daiooo/sistemas-de-aterramento/README.md

Sistemas de Aterramento
=======

Projeto: Sistemas de Aterramento

### Equipe:
* Ricardo Thé
* Tobias Fernandes
* Rodrigo Paulino
* Felipe Bandeira 
* Franscico Alexandre
* António Thé
* Henrique
* Rooney
* Kristian 
* Alberto de Castro

felipeband18 at gmail dot com
