daiooo/sistemas-de-aterramento/esquematico/placa_potencia_versao_2/gerb/LEIAME

LEGENDA:
    Top and bottom copper (.GTL, .GBL)
    Top and bottom solder mask (.GTS, .GBS)
    Top and bottom silkscreen (.GTO, .GBO)
    Drill file, 2.4 leading (.TXT)
	MILL and Dimension (.GML)
