daiooo/sistemas-de-aterramento/esquematico/placa_tobias/gerb/LEIAME

LEGENDA:
    Top and bottom copper (.GTL, .GBL)
    Drill file, 2.4 leading (.TXT)
    MILL and Dimension (.GML)
