daiooo/sistemas-de-aterramento/esquematico/placa_controle/gerber_controle/controle - CADCAM Mechanical 1.TXT

G04 PROTEUS RS274X GERBER FILE*
%FSLAX24Y24*%
%MOIN*%
%ADD16C,0.0080*%
G54D16*
X-32952Y-37468D02*
X+30000Y-37468D01*
X+30000Y+10500D01*
X-32952Y+10500D01*
X-32952Y-37468D01*
M00*
