daiooo/sistemas-de-aterramento/esquematico/placa_potencia/gerbes_potencia/potencia - CADCAM Mechanical 1.TXT

G04 PROTEUS RS274X GERBER FILE*
%FSLAX24Y24*%
%MOIN*%
%ADD13C,0.0080*%
G54D13*
X-33000Y-22500D02*
X+30000Y-22500D01*
X+30000Y+26000D01*
X-33000Y+26000D01*
X-33000Y-22500D01*
M00*
