daiooo/sistemas-de-aterramento/fotos/conexoes/frontal.pdf

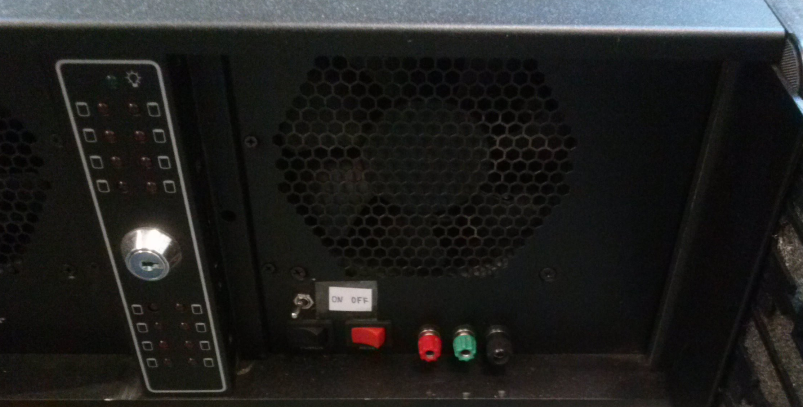
[picture p12: page 1]
