daiooo/sistemas-de-aterramento/fotos/execucao/terminal.pdf

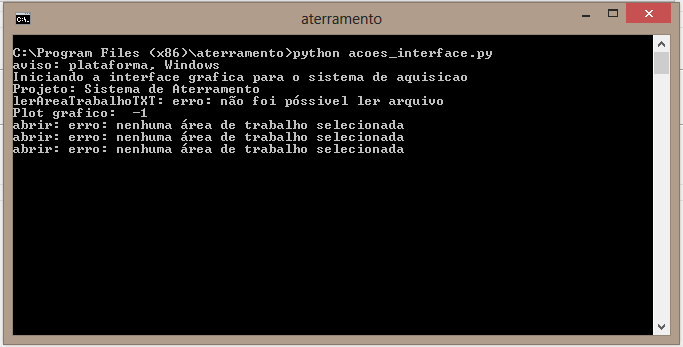
[picture p13: page 1]
