daiooo/sistemas-de-aterramento/fotos/instalacao/parte1_executando.pdf

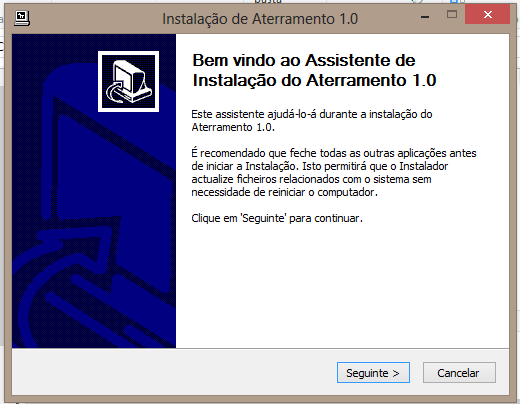
[picture p14: page 1]
