daiooo/sistemas-de-aterramento/fotos/instalacao/parte3_descompactando.pdf

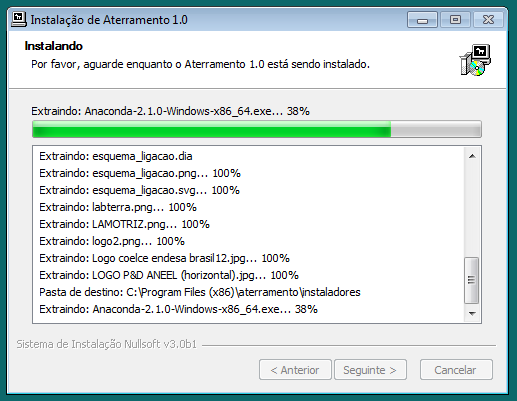
[picture p15: page 1]
