daiooo/sistemas-de-aterramento/fotos/instalacao/parte5_instalando_pyvisa.pdf

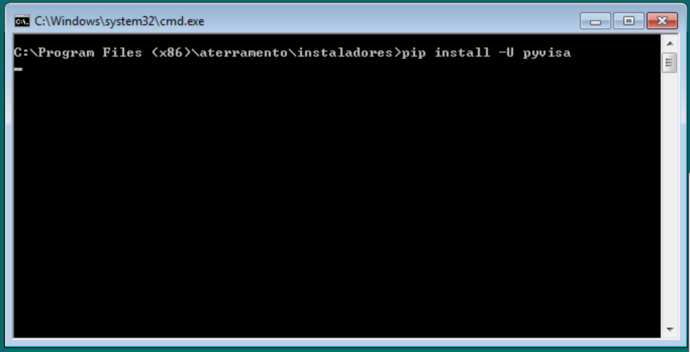
[picture p16: page 1]
