daiooo/sistemas-de-aterramento/fotos/instalacao/parte6_pyqt.pdf

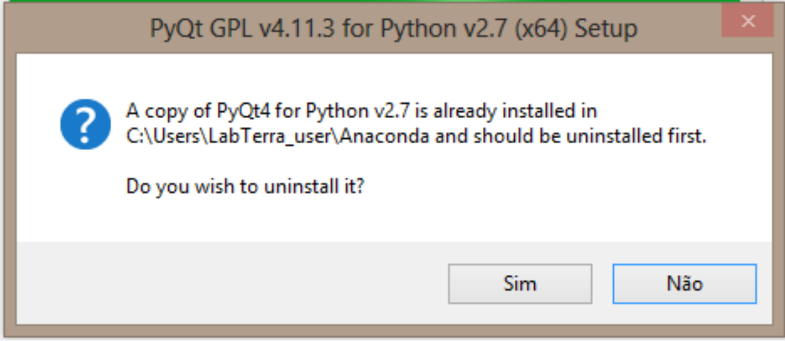
[picture p17: page 1]
