daiooo/sistemas-de-aterramento/fotos/CAM00064.jpg

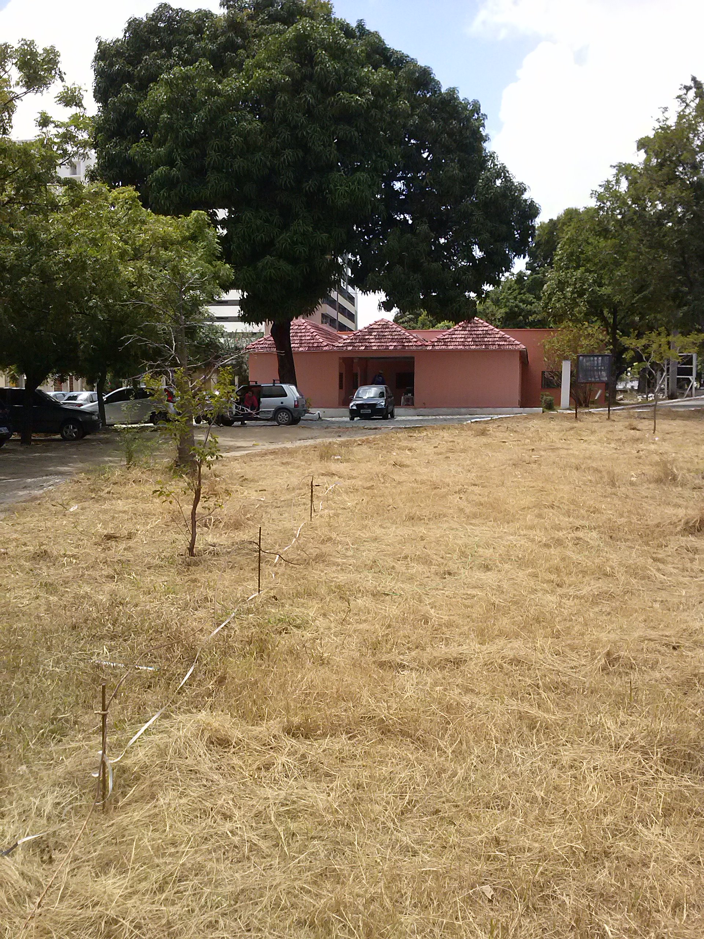
fotos/CAM00064.jpg
