daiooo/sistemas-de-aterramento/fotos/CAM00080.jpg

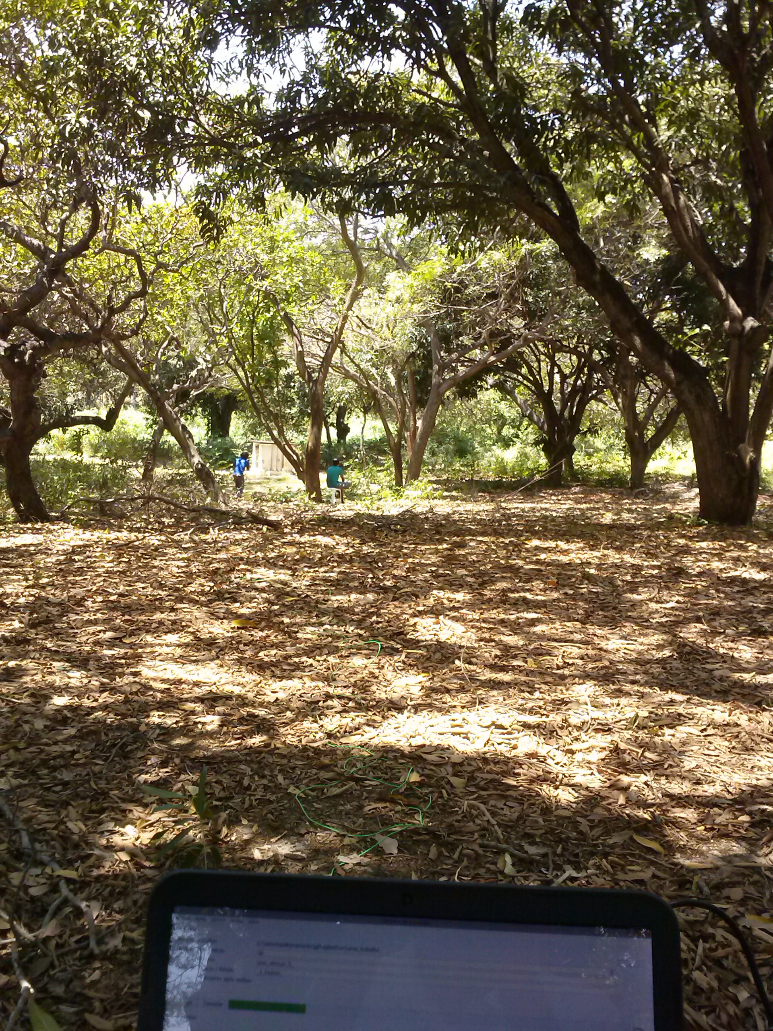
fotos/CAM00080.jpg
