daiooo/sistemas-de-aterramento/fotos/CAM00374.jpg

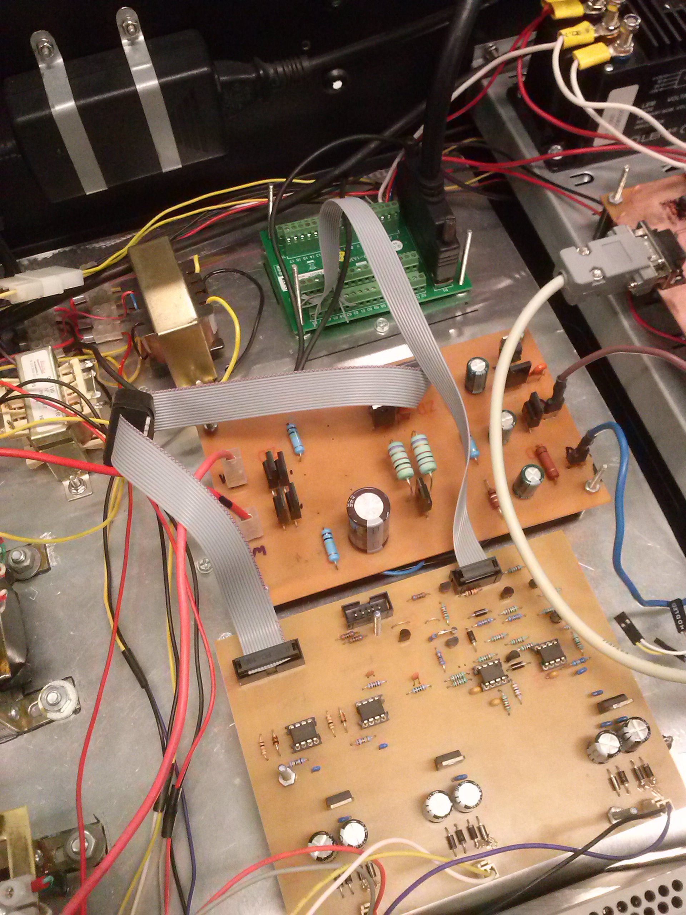
fotos/CAM00374.jpg
