daiooo/sistemas-de-aterramento/fotos/CAM00375.jpg

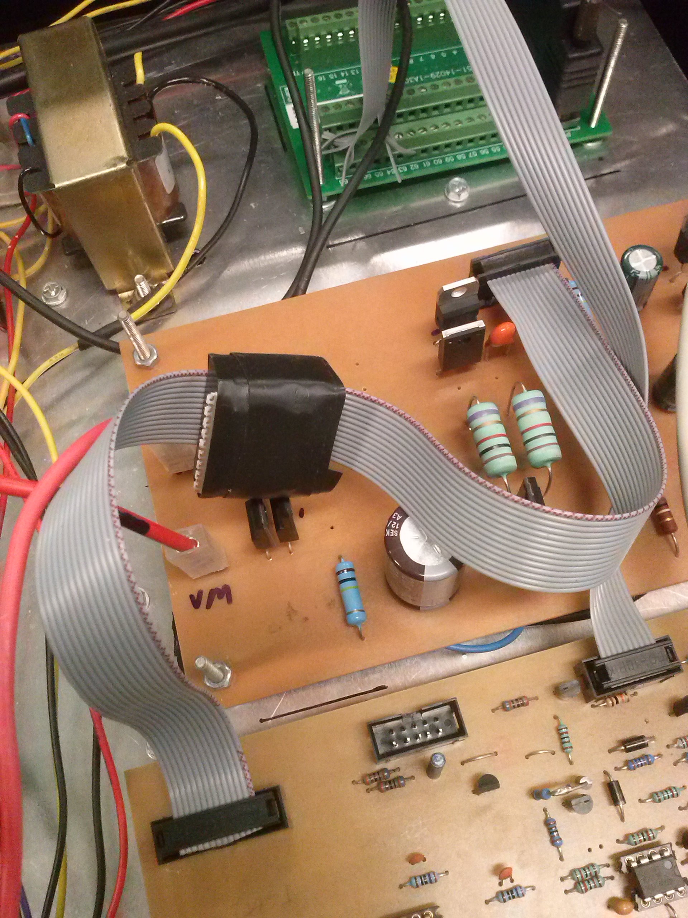
fotos/CAM00375.jpg
