daiooo/sistemas-de-aterramento/fotos/CAM00376.jpg

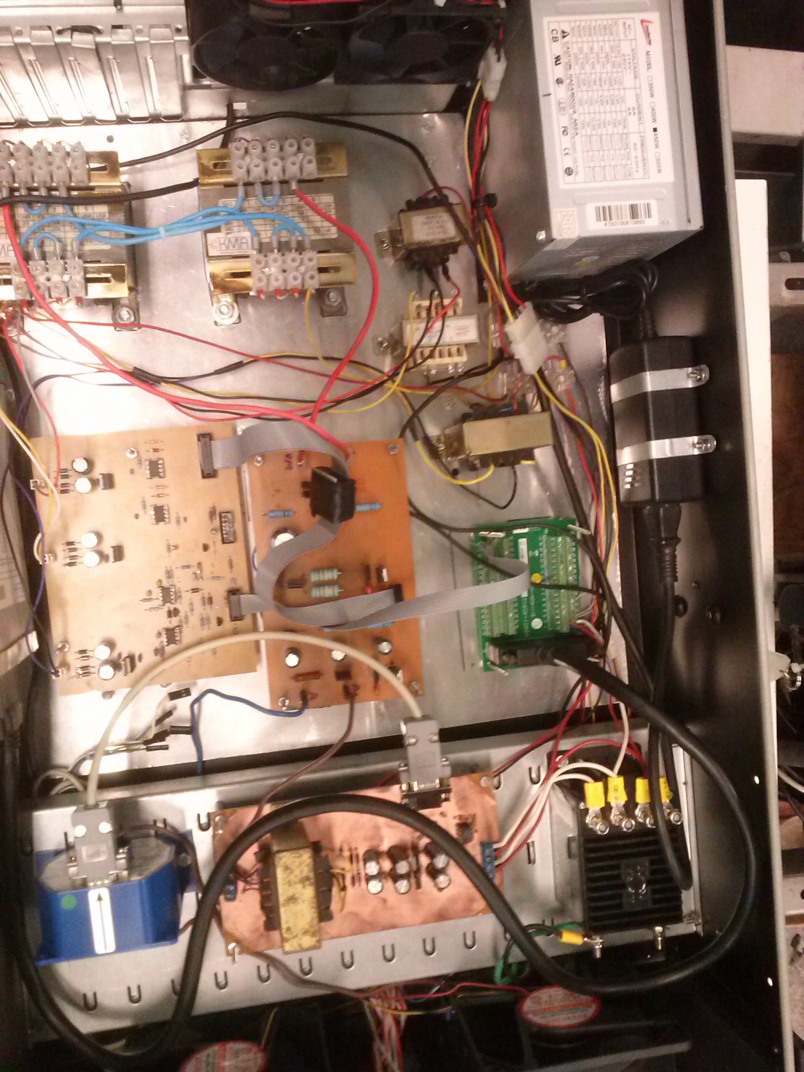
fotos/CAM00376.jpg
