daiooo/sistemas-de-aterramento/fotos/CAM00377.jpg

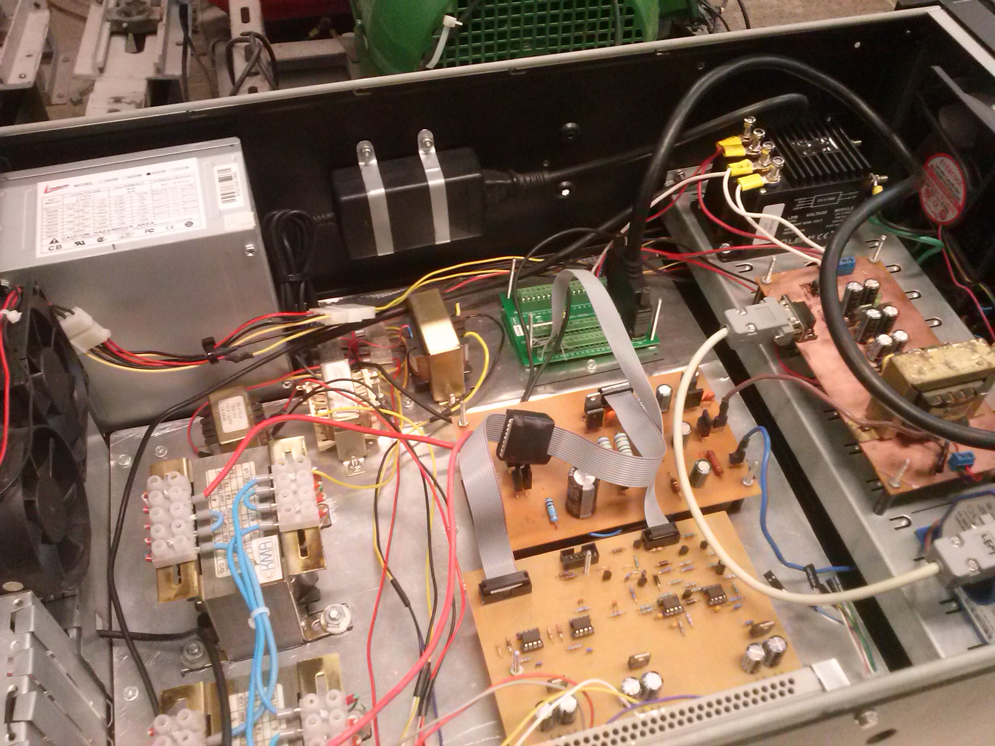
fotos/CAM00377.jpg
