daiooo/sistemas-de-aterramento/fotos/CAM00378.jpg

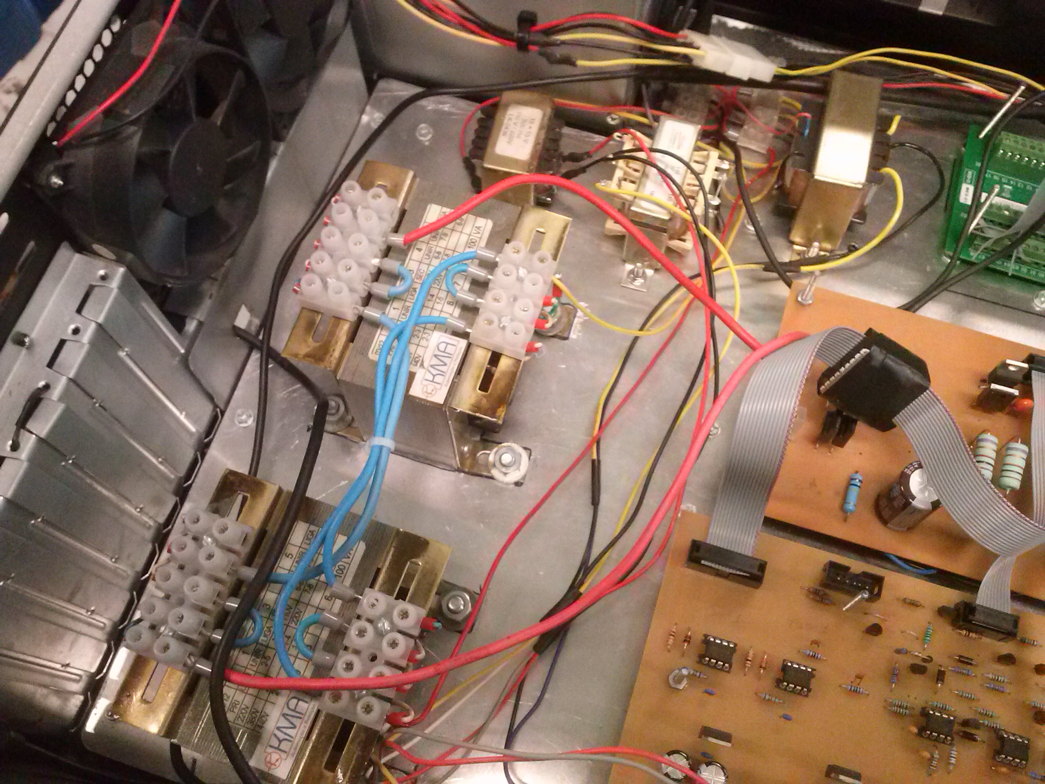
fotos/CAM00378.jpg
