daiooo/sistemas-de-aterramento/fotos/CAM00713.jpg

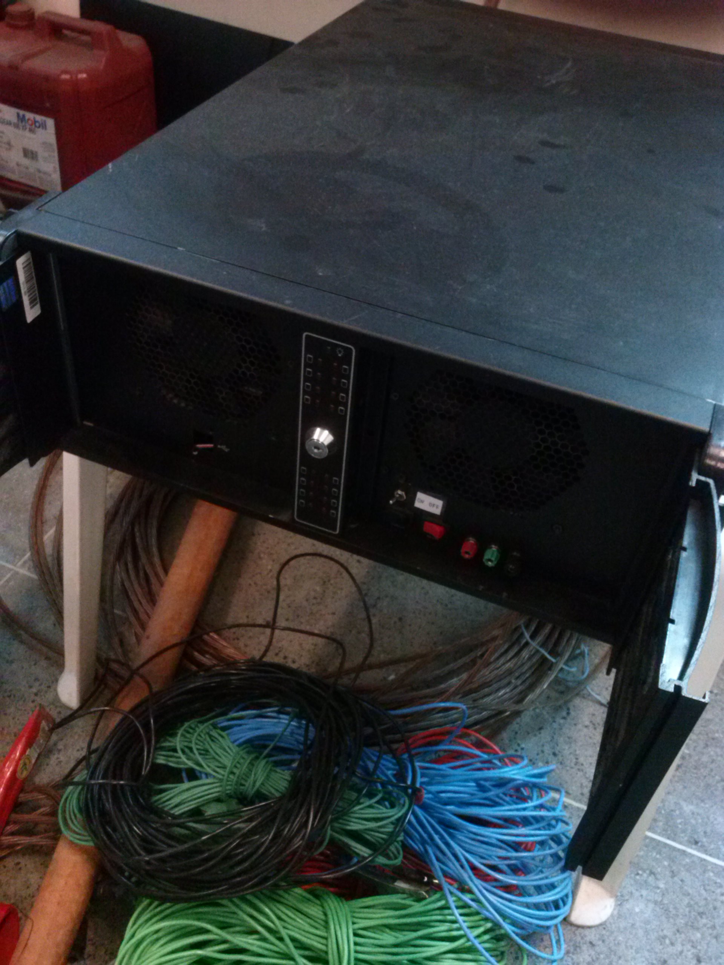
fotos/CAM00713.jpg
