daiooo/sistemas-de-aterramento/fotos/CAM00714.jpg

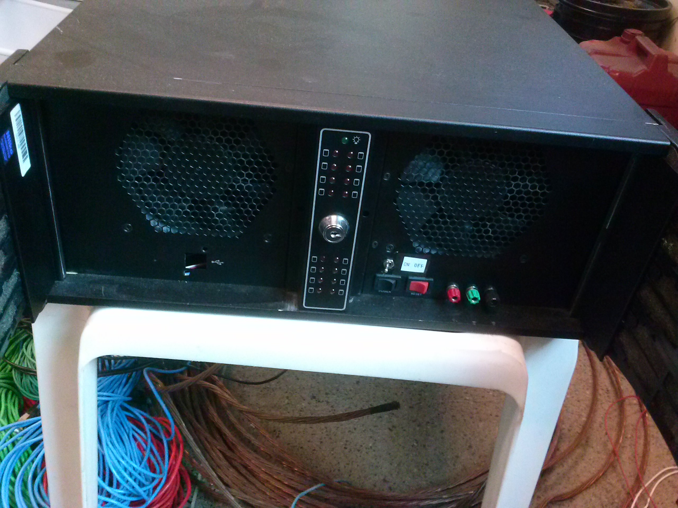
fotos/CAM00714.jpg
