daiooo/sistemas-de-aterramento/fotos/CAM00715.jpg

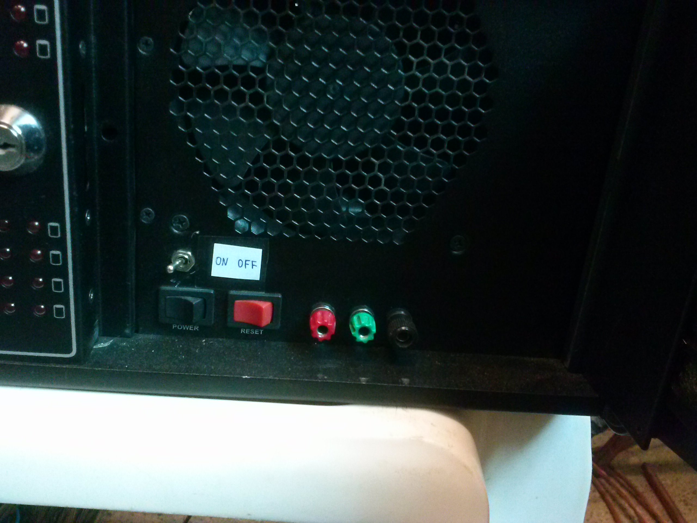
fotos/CAM00715.jpg
