daiooo/sistemas-de-aterramento/fotos/CAM00716.jpg

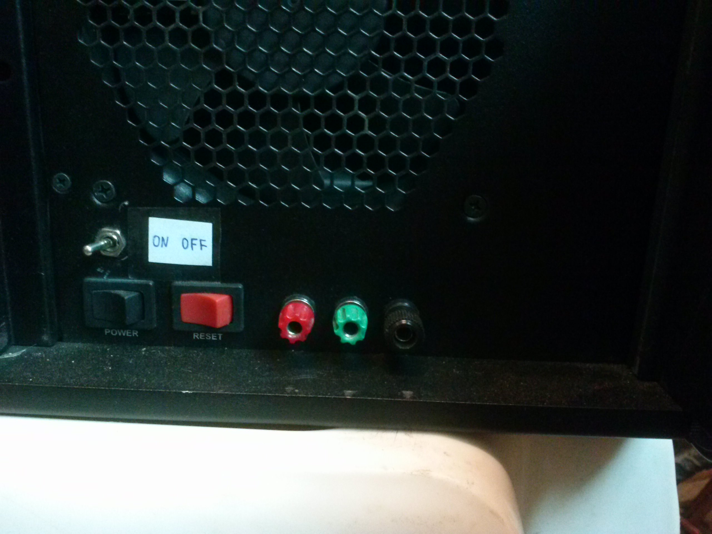
fotos/CAM00716.jpg
