daiooo/sistemas-de-aterramento/fotos/CAM00717.jpg

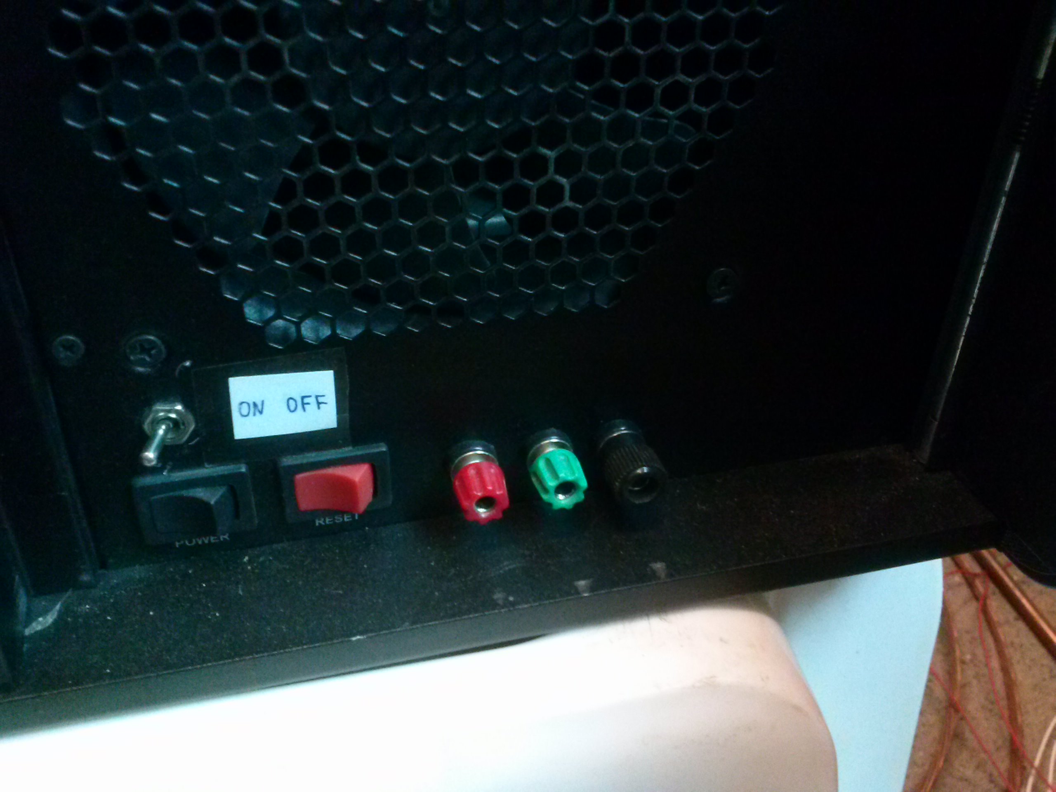
fotos/CAM00717.jpg
