daiooo/sistemas-de-aterramento/fotos/CAM00718.jpg

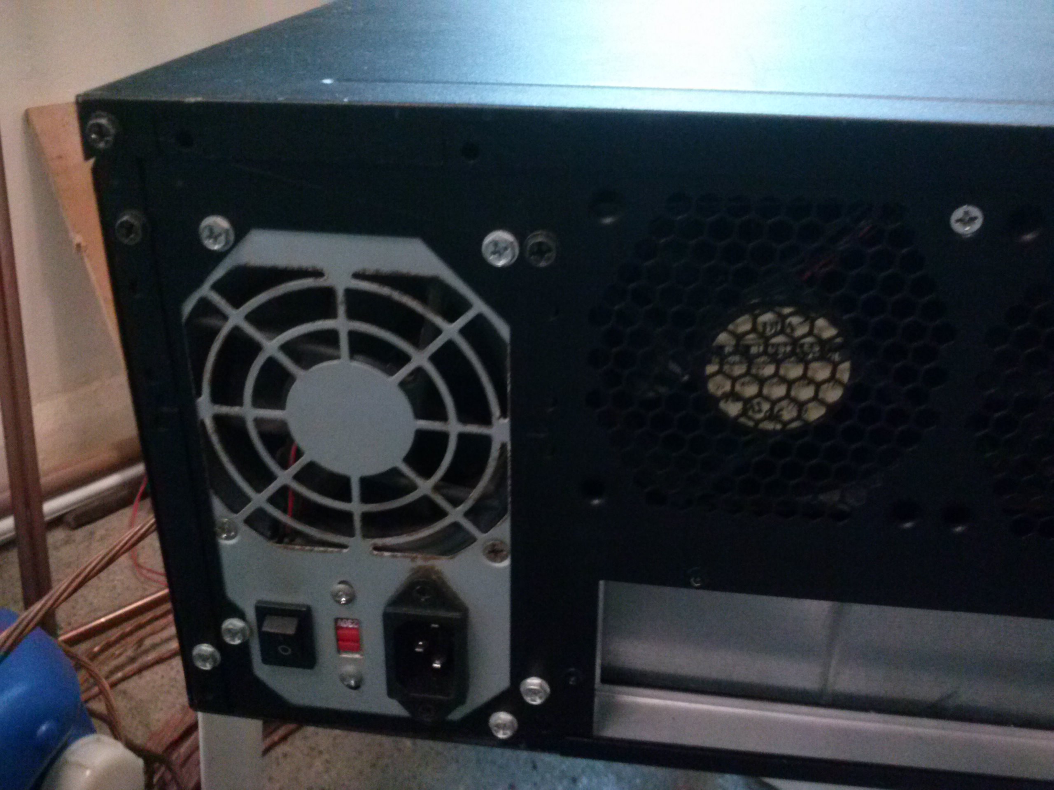
fotos/CAM00718.jpg
