daiooo/sistemas-de-aterramento/fotos/CAM00719.jpg

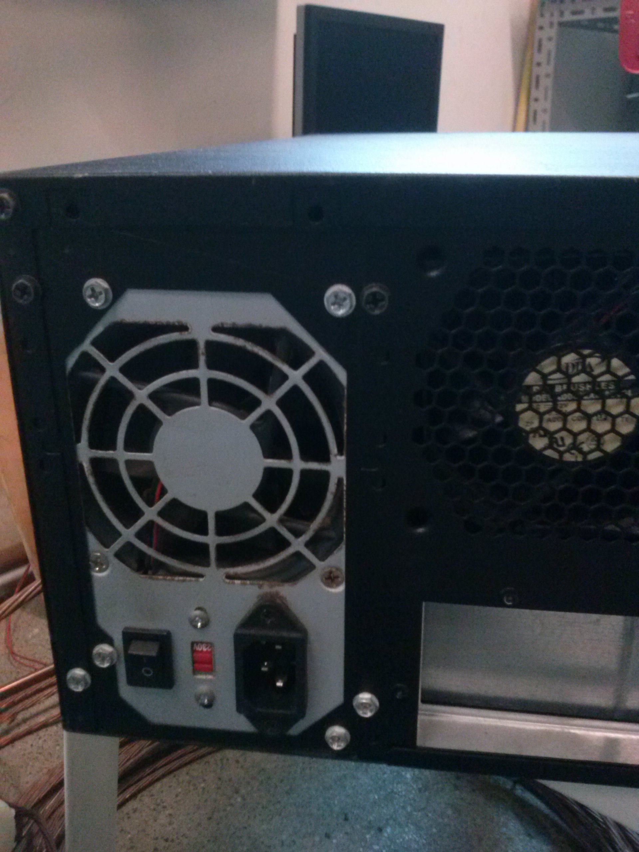
fotos/CAM00719.jpg
