daiooo/sistemas-de-aterramento/fotos/CAM00720.jpg

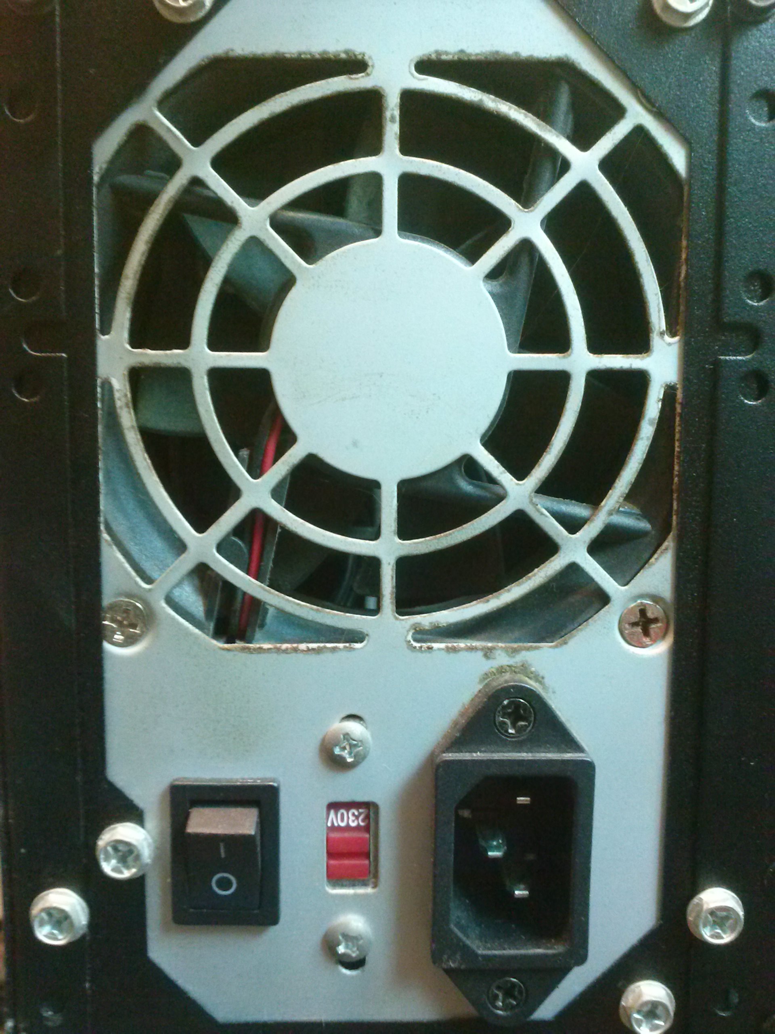
fotos/CAM00720.jpg
