daiooo/sistemas-de-aterramento/fotos/CAM00721.jpg

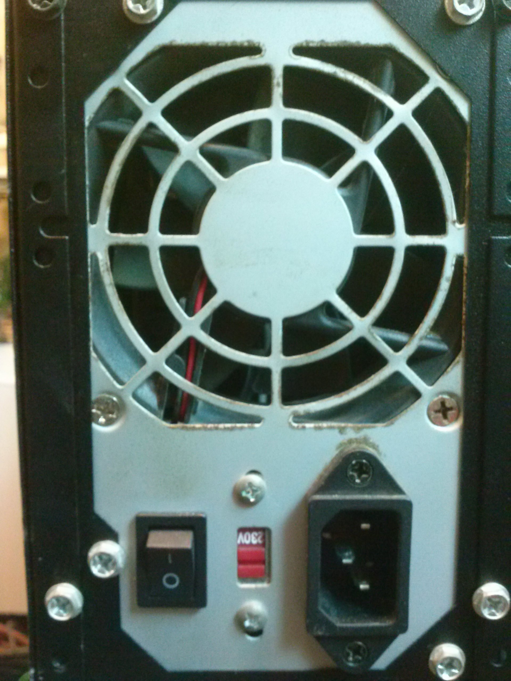
fotos/CAM00721.jpg
