daiooo/sistemas-de-aterramento/fotos/CAM00741.jpg

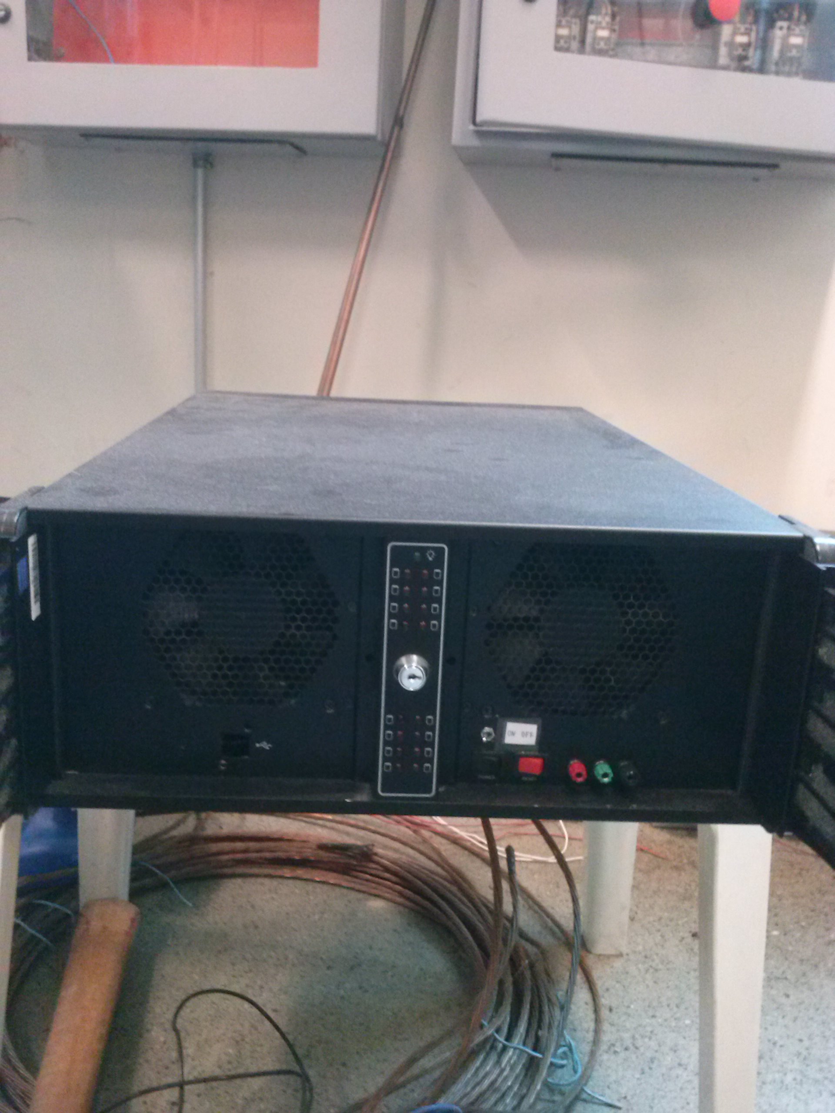
fotos/CAM00741.jpg
