daiooo/sistemas-de-aterramento/fotos/CAM00742.jpg

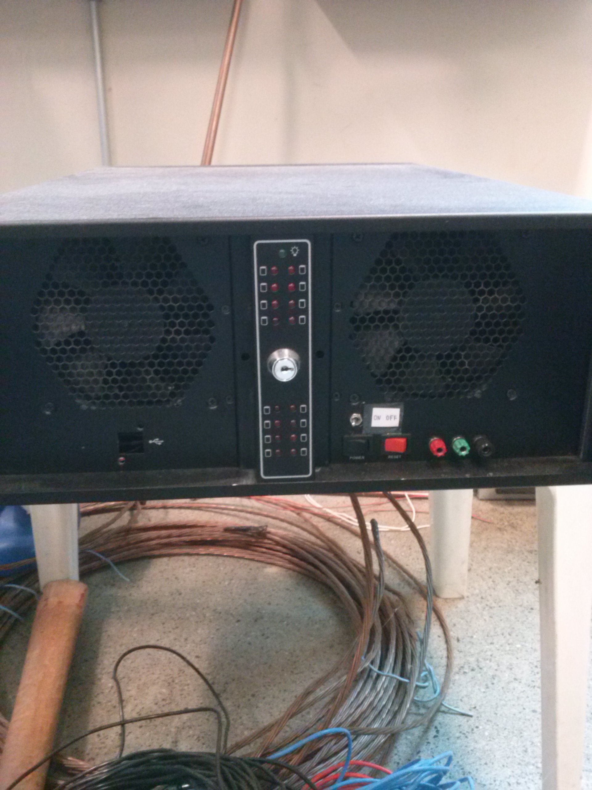
fotos/CAM00742.jpg
