daiooo/sistemas-de-aterramento/fotos/CAM00743.jpg

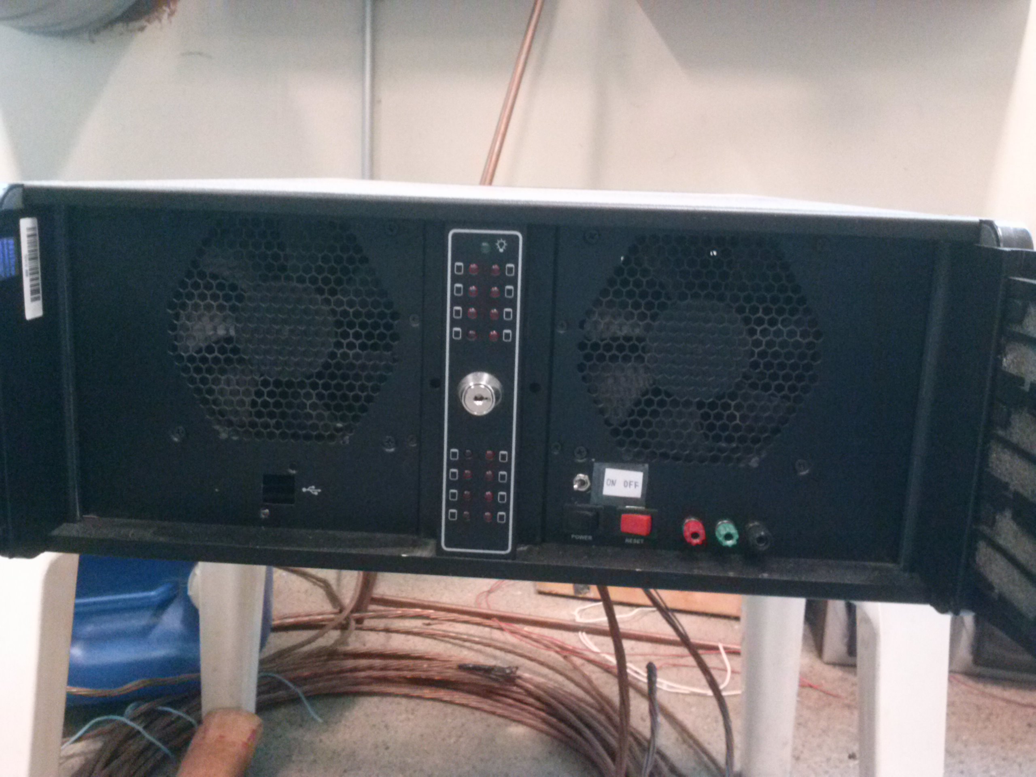
fotos/CAM00743.jpg
