daiooo/sistemas-de-aterramento/fotos/CAM00744.jpg

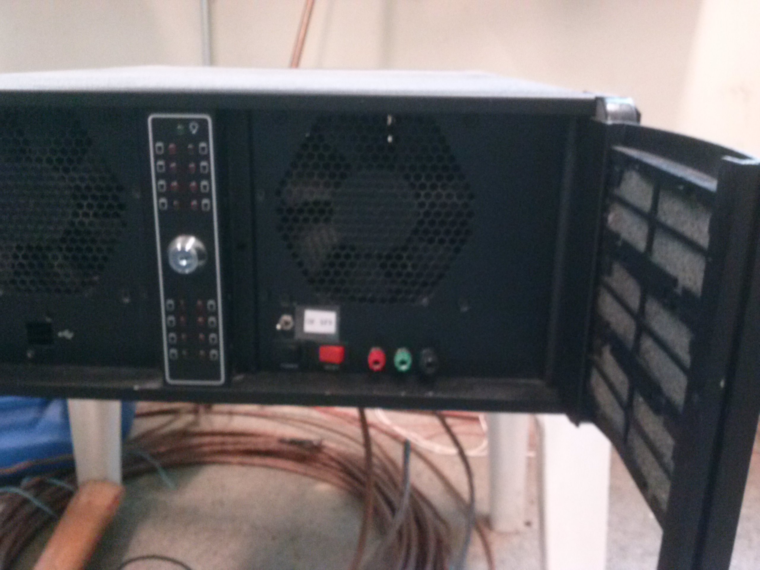
fotos/CAM00744.jpg
