daiooo/sistemas-de-aterramento/fotos/CAM00745.jpg

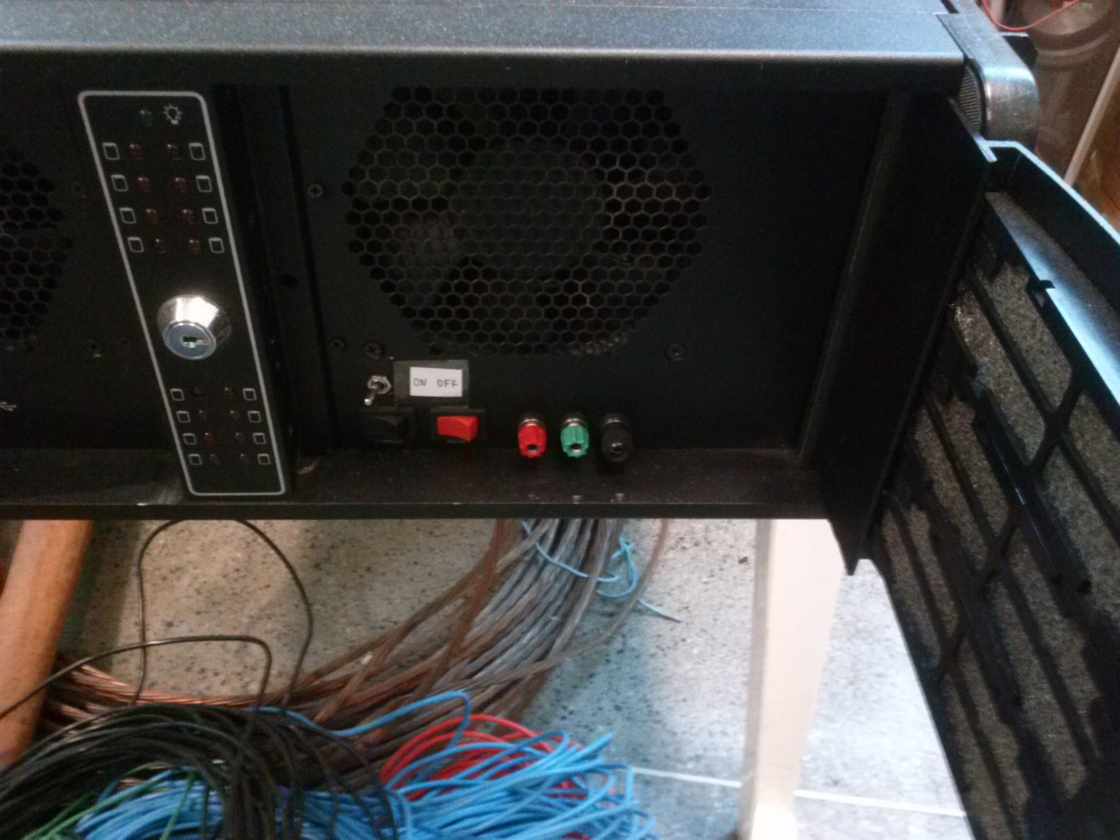
fotos/CAM00745.jpg
