daiooo/sistemas-de-aterramento/fotos/execucao/selecionando_area_trabalho.png

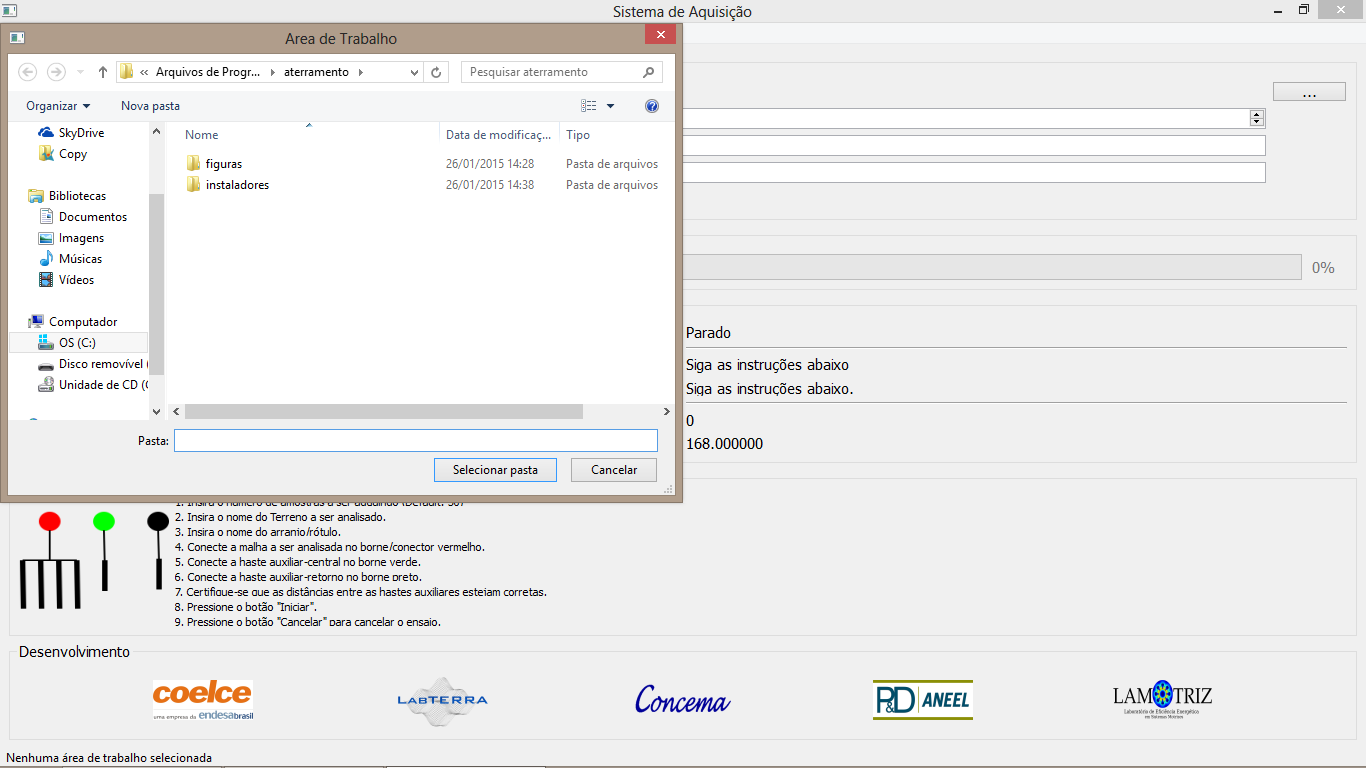
fotos/execucao/selecionando_area_trabalho.png
