daiooo/sistemas-de-aterramento/fotos/execucao/terminal.png

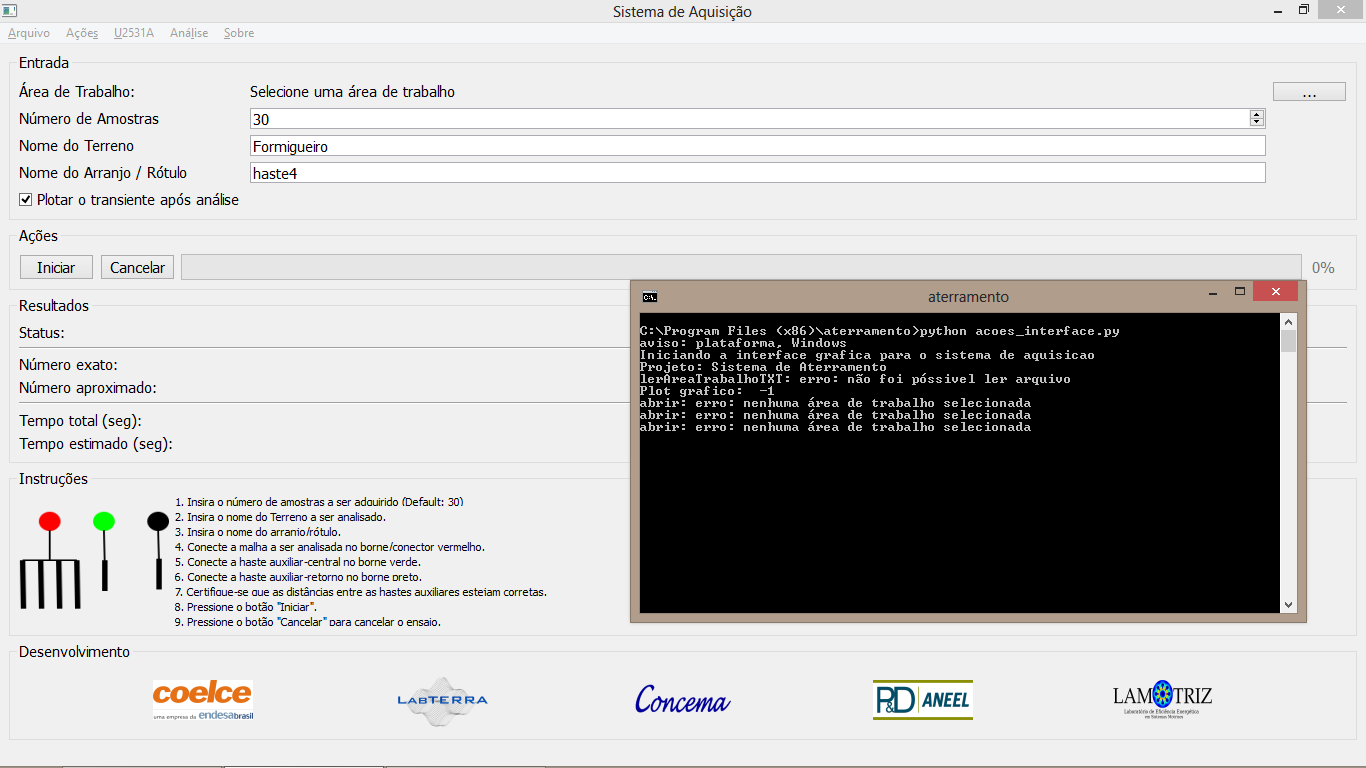
fotos/execucao/terminal.png
