daiooo/sistemas-de-aterramento/fotos/u2531a.png

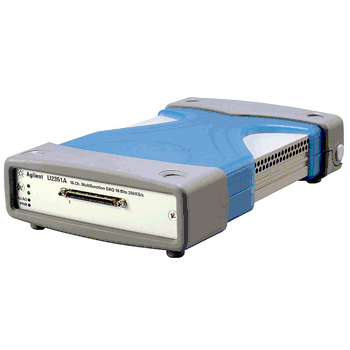
fotos/u2531a.png
