daiooo/sistemas-de-aterramento/src/figuras/esquema_ligacao.png

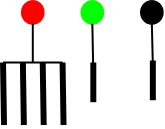
src/figuras/esquema_ligacao.png
