daiooo/sistemas-de-aterramento/src/figuras/labterra.png

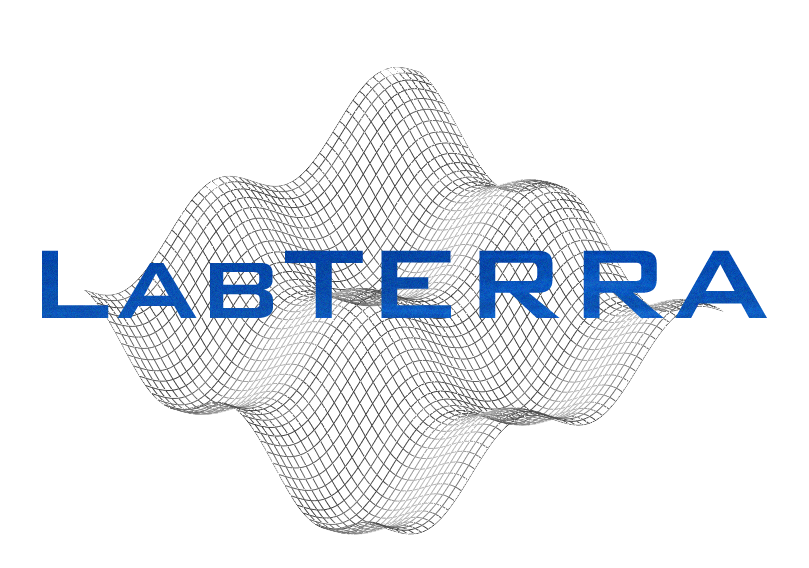
src/figuras/labterra.png
