daiooo/sistemas-de-aterramento/src/figuras/LAMOTRIZ.png

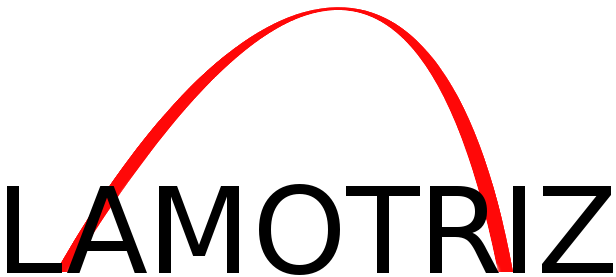
src/figuras/LAMOTRIZ.png
