daiooo/sistemas-de-aterramento/fotos/instalacao/parte2_selecionando_componentes.pdf

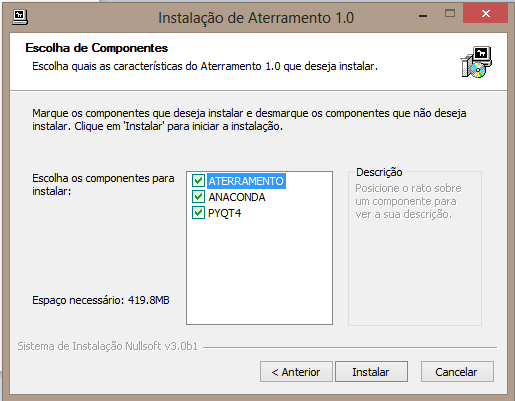
[picture p45: page 1]
