daiooo/sistemas-de-aterramento/fotos/instalacao/parte4_instalando_componentes_externos.pdf

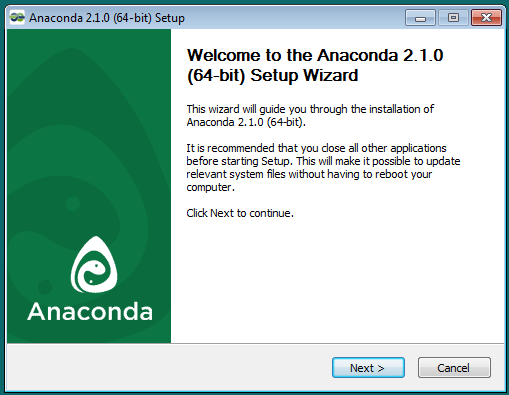
[picture p46: page 1]
