daiooo/sistemas-de-aterramento/(list of files, cad)

Other CAD files:
p16/dist/default/production/p16.production.obj
p16/l.obj
