daiooo/sistemas-de-aterramento/manual/esquema_de_ligacao.pdf

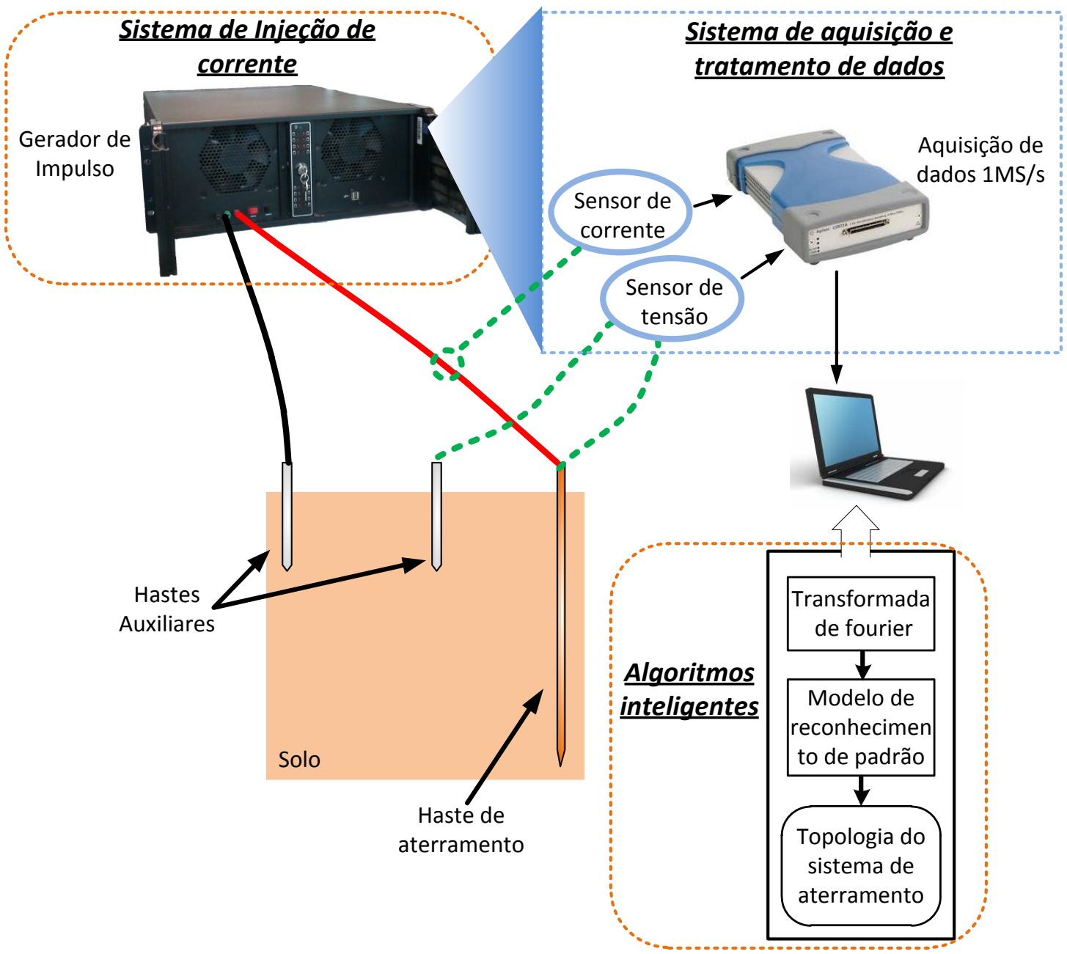
[picture p47: figure]
Solo; Hastes Auxiliares; Haste de aterramento; Gerador de Impulso; Aquisição de dados 1MS/s; Transformada de fourier; Modelo de reconhecimen to de padrão; Topologia do sistema de aterramento; Sensor de tensão; Sensor de corrente; Sistema de Injeção de corrente; Sistema de aquisição e tratamento de dados; Algoritmos inteligentes
