daiooo/sistemas-de-aterramento/esquematico/placa_controle/gerber_controle/controle - CADCAM Bottom Solder Resist.TXT

G04 PROTEUS RS274X GERBER FILE*
%FSLAX24Y24*%
%MOIN*%
%ADD20C,0.1381*%
%ADD21C,0.0987*%
%ADD22R,0.0987X0.0987*%
%ADD23C,0.0790*%
%ADD16C,0.0080*%
G54D20*
X-2000Y-30000D03*
X+1000Y-30000D03*
X-6791Y-28729D03*
X-4500Y-29000D03*
G54D21*
X-26515Y+8500D03*
X-25515Y+8500D03*
G54D20*
X-28000Y+5500D03*
X-28000Y+1500D03*
X-22500Y+1500D03*
X-22500Y+5500D03*
X-28000Y-1500D03*
X-26000Y-1500D03*
X-23500Y-1500D03*
X-21500Y-1500D03*
G54D21*
X-26500Y-4500D03*
X-27500Y-4500D03*
X-25000Y-4500D03*
X-24000Y-4500D03*
X+500Y+8500D03*
X+1500Y+8500D03*
G54D20*
X+500Y+5500D03*
X+500Y+1500D03*
X-1000Y+5500D03*
X-1000Y+1500D03*
X+2500Y+1500D03*
X+2500Y+5500D03*
X+4000Y+1500D03*
X+4000Y+5500D03*
X-1000Y-1500D03*
X+1000Y-1500D03*
X+3500Y-1500D03*
X+5500Y-1500D03*
G54D21*
X+500Y-4500D03*
X-500Y-4500D03*
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
