daiooo/sistemas-de-aterramento/esquematico/placa_potencia/gerbes_potencia/potencia - CADCAM Bottom Solder Resist.TXT

G04 PROTEUS RS274X GERBER FILE*
%FSLAX24Y24*%
%MOIN*%
%ADD15R,0.1381X0.0987*%
%ADD16C,0.1381*%
%ADD17C,0.0987*%
%ADD13C,0.0080*%
G54D15*
X-30000Y+3500D03*
X-30000Y+2500D03*
X-30000Y+1500D03*
X-30000Y+500D03*
G54D16*
X-25000Y+7500D03*
X-25000Y+9500D03*
X-21500Y+7500D03*
X-21500Y+9500D03*
X-25000Y-5500D03*
X-25000Y-3500D03*
X-21500Y-5500D03*
X-21500Y-3500D03*
X-12000Y+22000D03*
X-12000Y+18850D03*
X-12000Y+13000D03*
X-12000Y+9850D03*
X-12000Y+4000D03*
X-12000Y+850D03*
X-12000Y-5000D03*
X-12000Y-8149D03*
X-12000Y-13500D03*
X-12000Y-16649D03*
X-16500Y+16000D03*
X-7500Y+16000D03*
X-16500Y+7000D03*
X-7500Y+7000D03*
X-16500Y-2000D03*
X-7500Y-2000D03*
X-16500Y-11000D03*
X-7500Y-11000D03*
X-16500Y-19500D03*
X-7500Y-19500D03*
X+3000Y+5500D03*
X+3000Y+14500D03*
X+7000Y+5500D03*
X+7000Y+14500D03*
X+5000Y+3000D03*
X+5000Y+1000D03*
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
