daiooo/sistemas-de-aterramento/esquematico/placa_controle/controle_esquematico.pdf

| A | B | C | D | E | F | G | H | J | K
0 | U1 | | | | | | | | | | 0

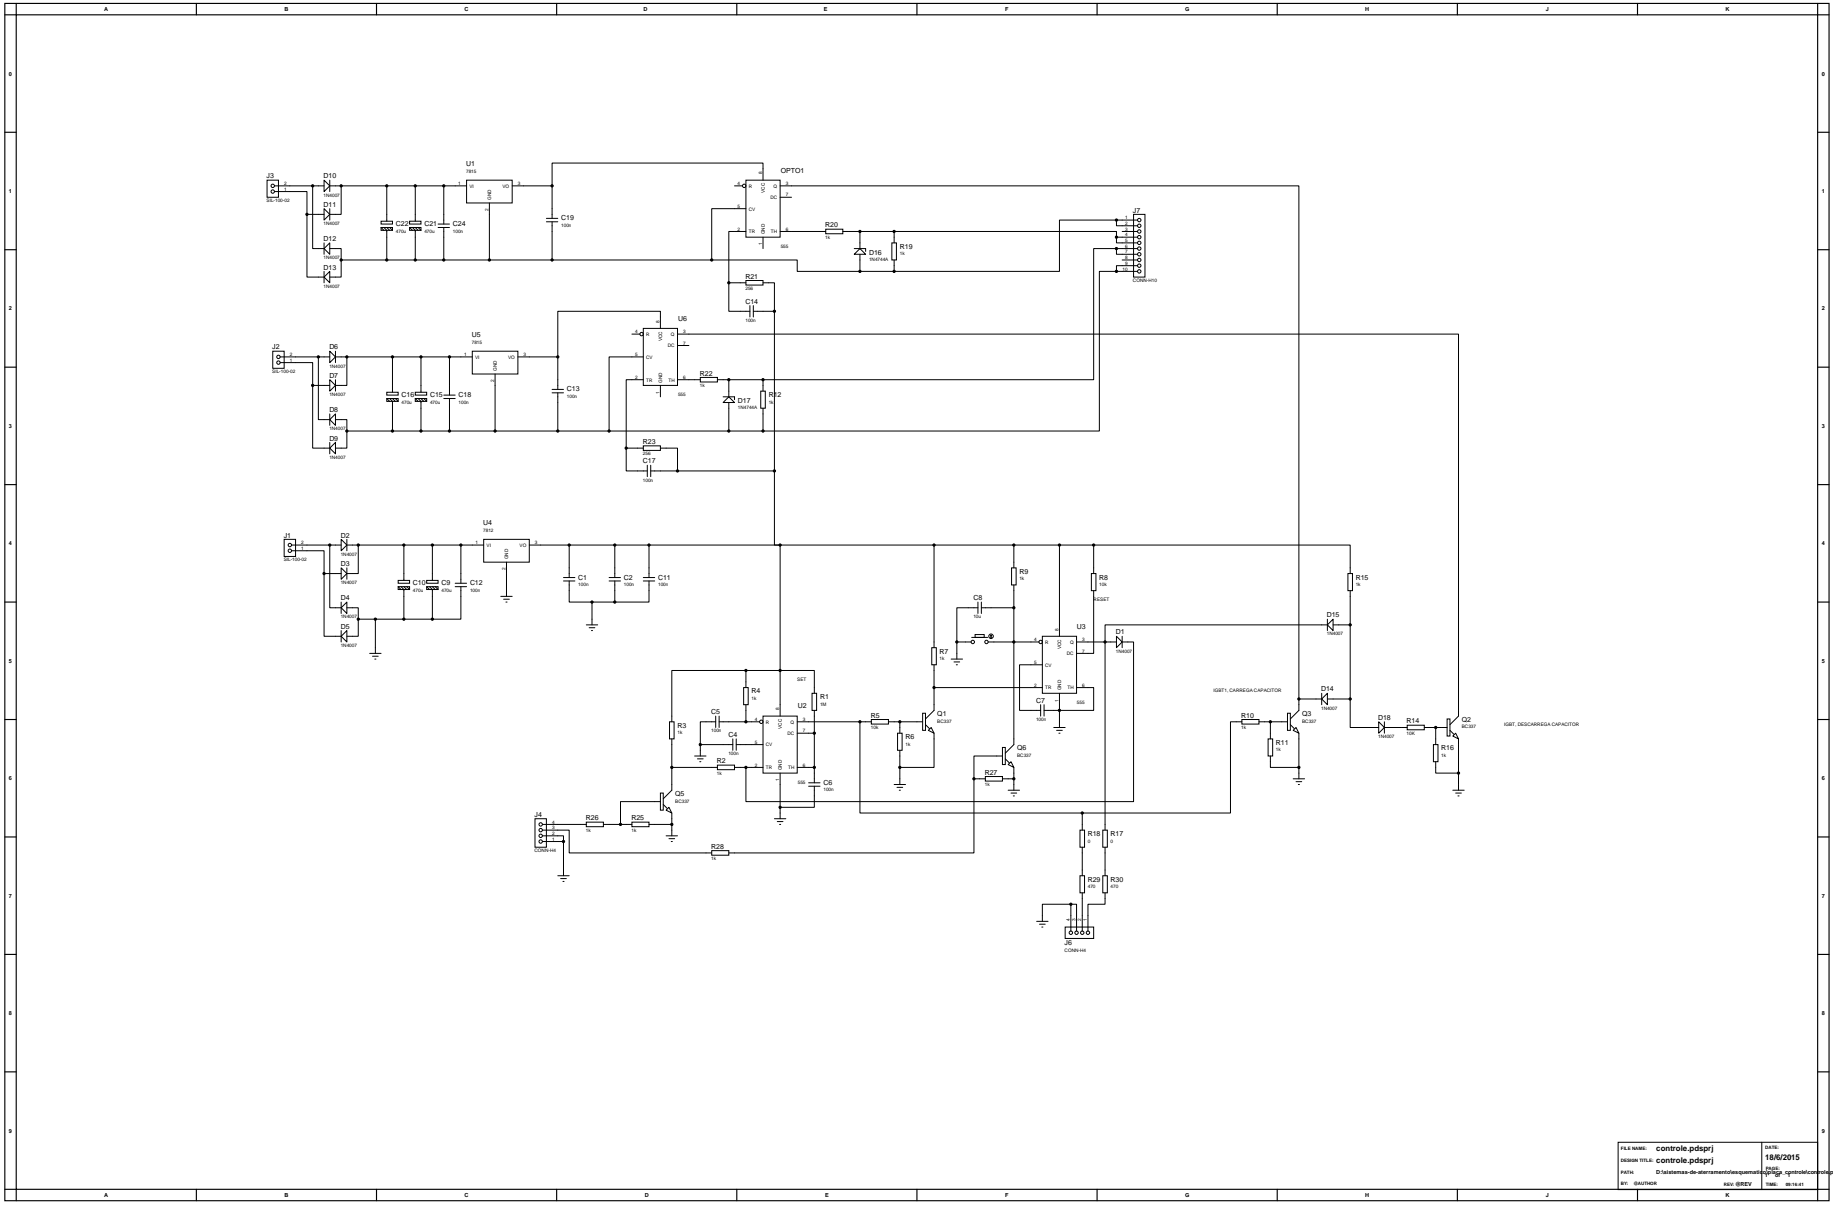
[picture p64: page 1]

GND 1 VCC 8 TR 2 TH 6 CV 5 OPTO1 555

GND 1 VCC 8 TR 2 TH 6 CV 5 U6 555

GND 1 VCC 8 TR 2 TH 6 CV 5 U3 555 SET

GND 1 VCC 8 TR 2 TH 6 CV 5 U2 555

controle.pdsprj FILE NAME: DESIGN TITLE: controle.pdsprj PATH: D:\sistemas-de-aterramento\esquematico\placa_controle\controle.p 1 of 1 BY: @AUTHOR REV:@REV | DATE: 18/6/2015 PAGE: TIME: 09:16:41
