daiooo/sistemas-de-aterramento/esquematico/placa_tobias/placa_TC.pdf

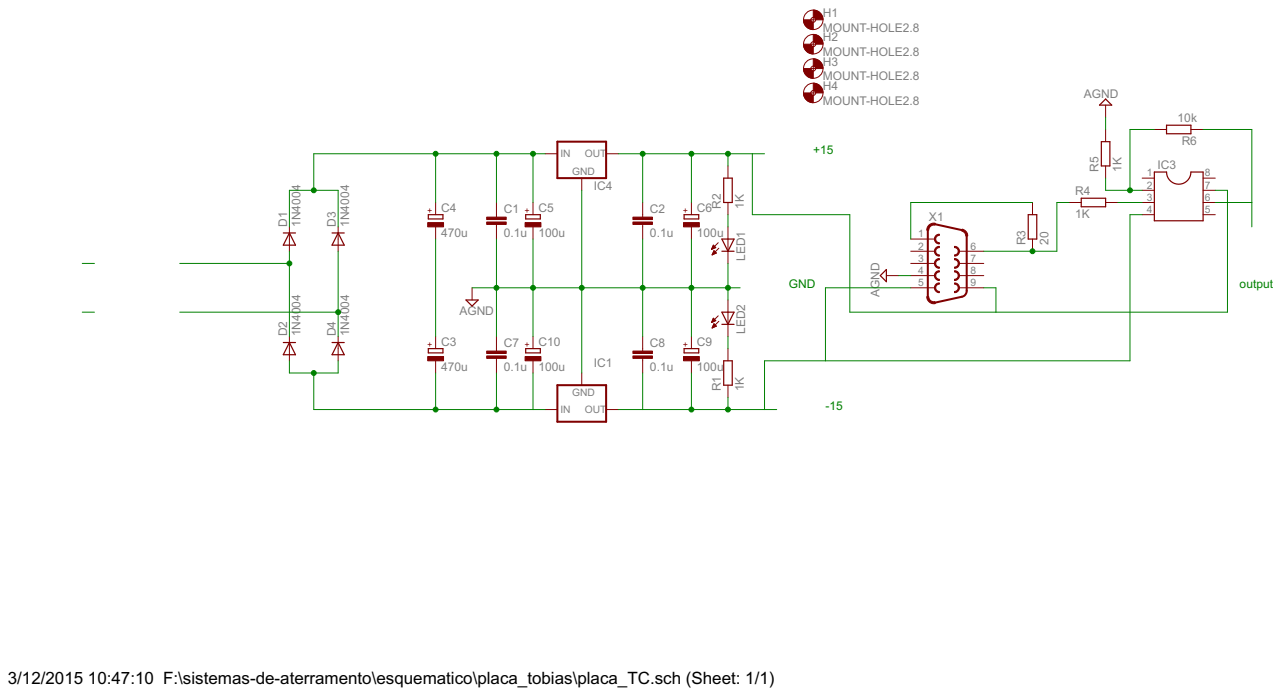
[picture p65: page 1]

3/12/2015 10:47:10 F:\sistemas-de-aterramento\esquematico\placa_tobias\placa_TC.sch (Sheet: 1/1)
