daiooo/sistemas-de-aterramento/esquematico/placa_tobias/placa_TC_pcb.pdf

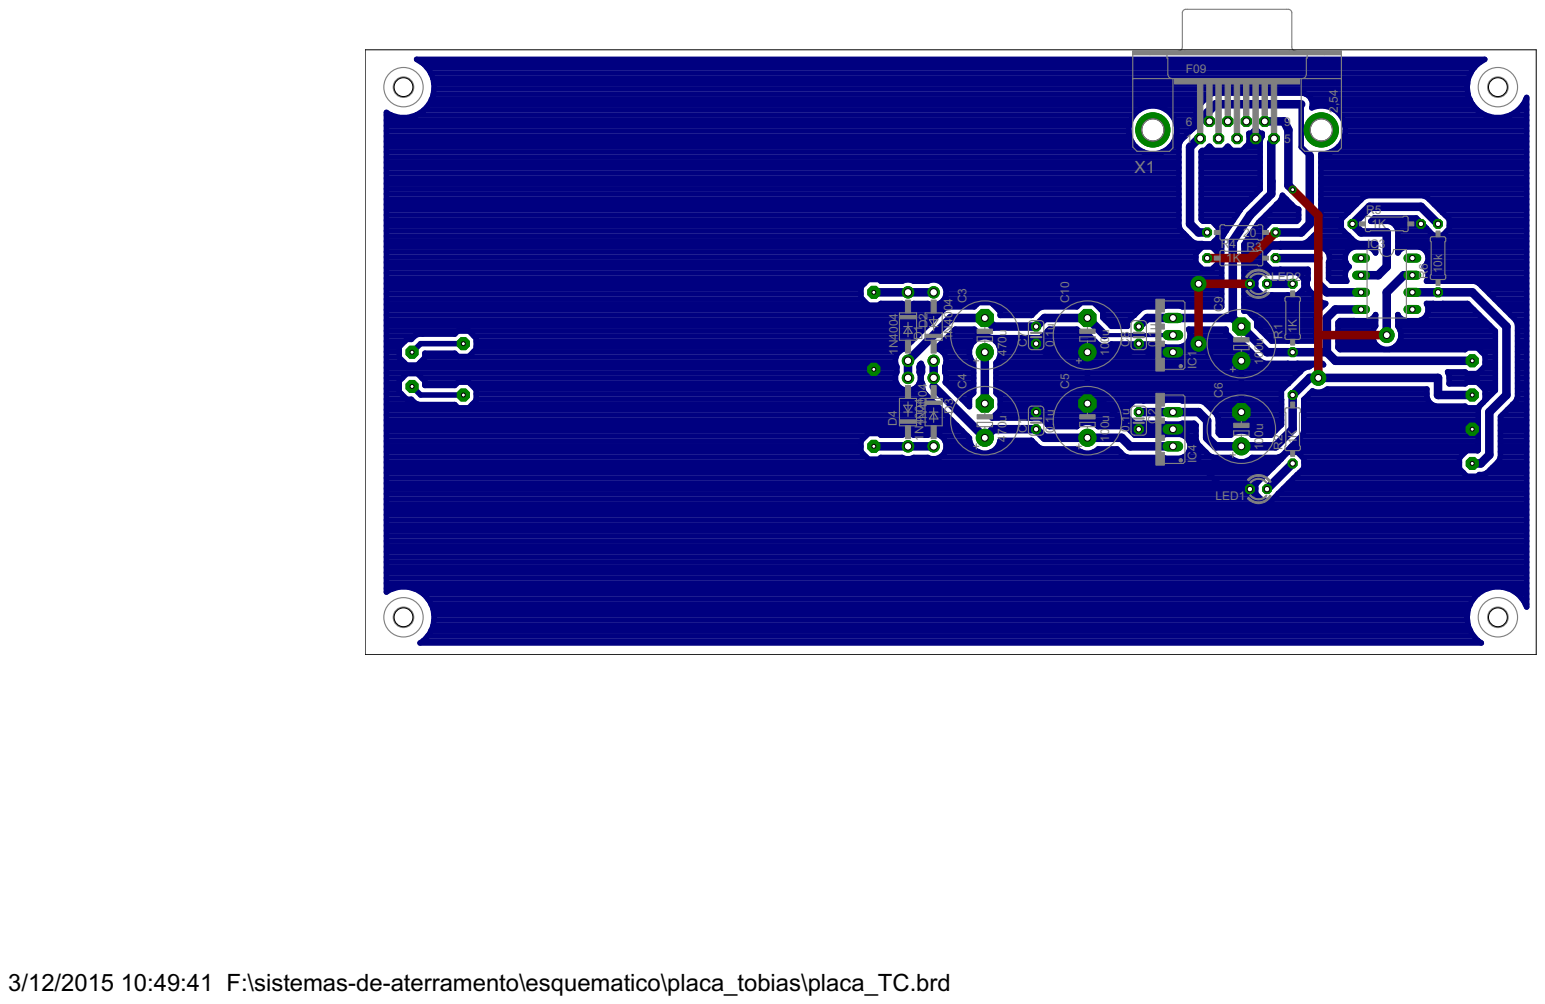
[picture p66: page 1]

3/12/2015 10:49:41 F:\sistemas-de-aterramento\esquematico\placa_tobias\placa_TC.brd
