daiooo/sistemas-de-aterramento/esquematico/placa_controle/controle_pcb.pdf

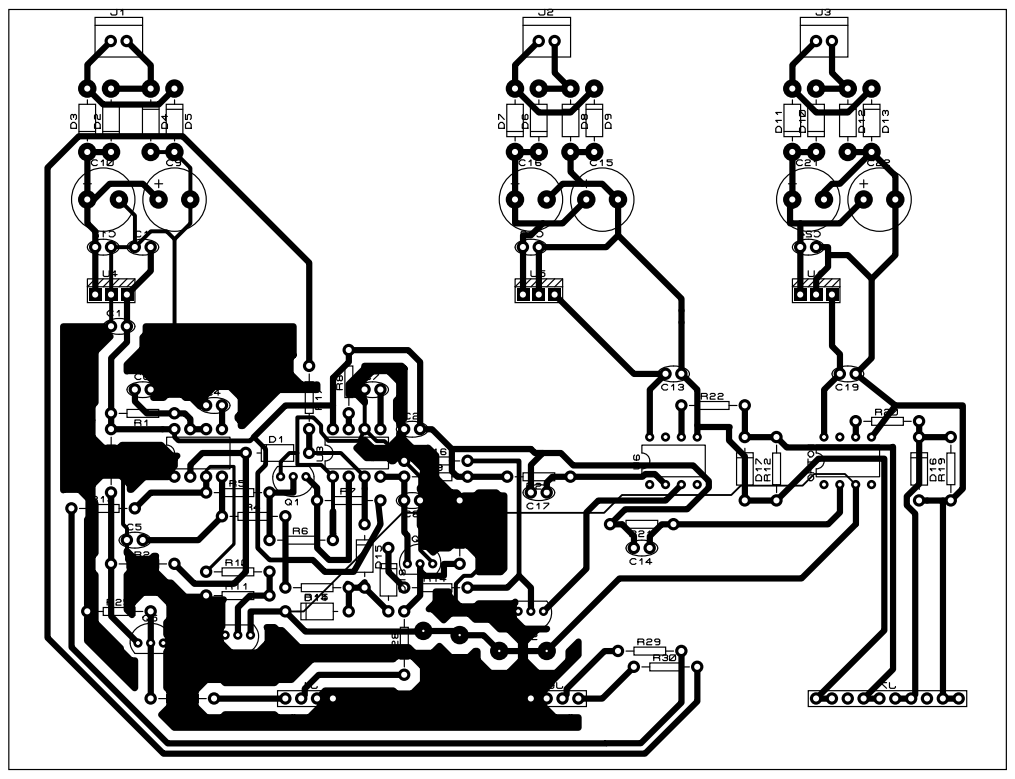
[picture p67: page 1]
