daiooo/sistemas-de-aterramento/esquematico/placa_potencia_versao_2/placa_potencia_esquematico.pdf

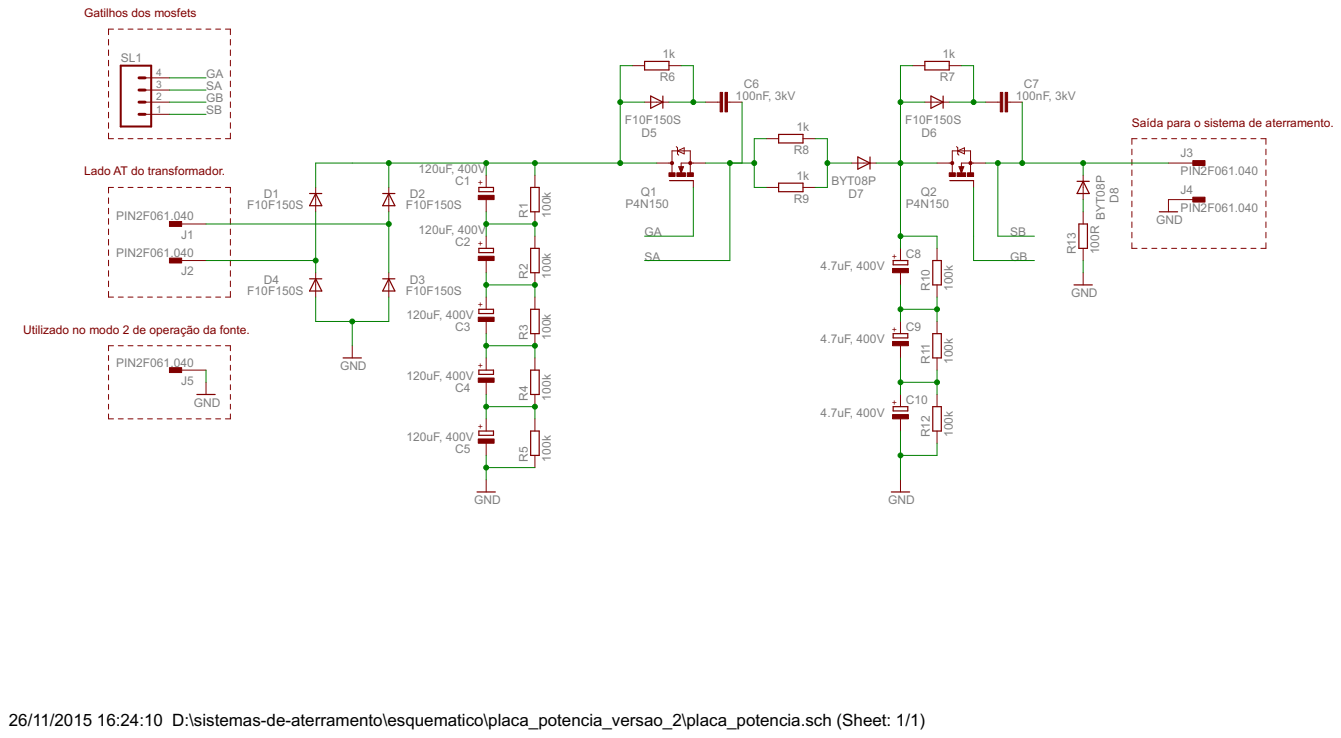
[picture p68: page 1]

Saída para o sistema de aterramento.

Lado AT do transformador.

Utilizado no modo 2 de operação da fonte.

26/11/2015 16:24:10 D:\sistemas-de-aterramento\esquematico\placa_potencia_versao_2\placa_potencia.sch (Sheet: 1/1)
