daiooo/sistemas-de-aterramento/esquematico/placa_potencia_versao_2/placa_potencia_pcb.pdf

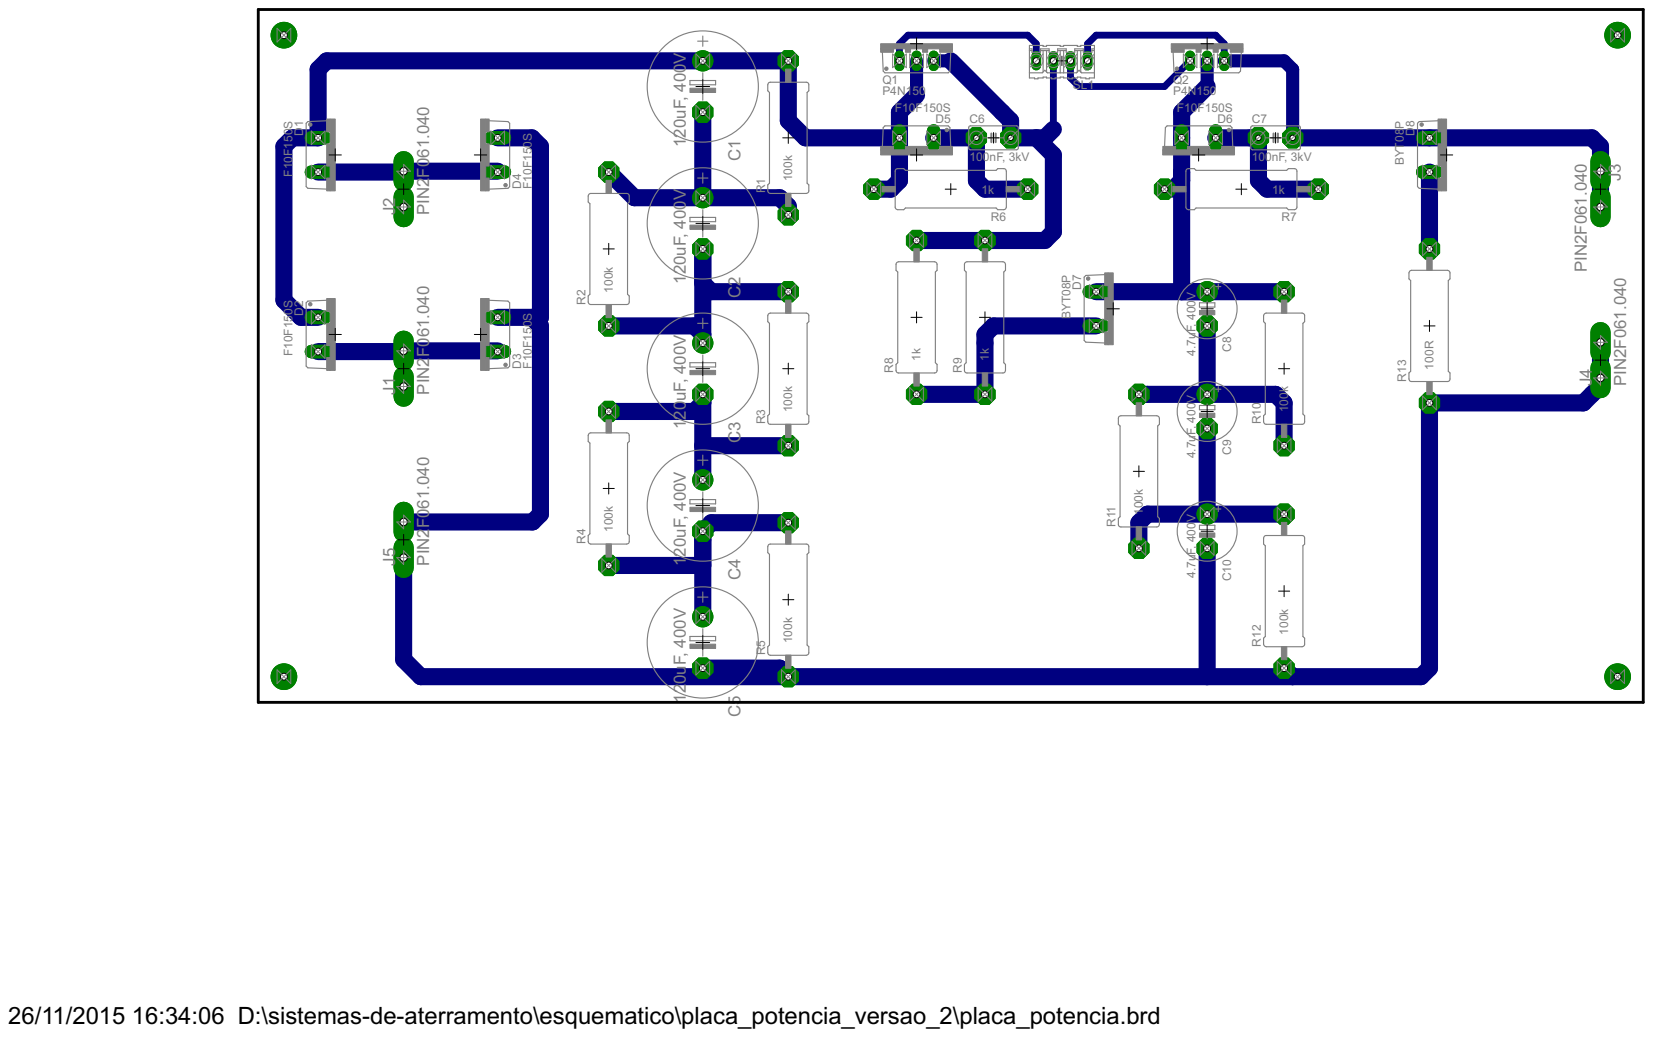
[picture p69: page 1]

26/11/2015 16:34:06 D:\sistemas-de-aterramento\esquematico\placa_potencia_versao_2\placa_potencia.brd
