daiooo/sistemas-de-aterramento/esquematico/iniciais/placa de Controle.pdf

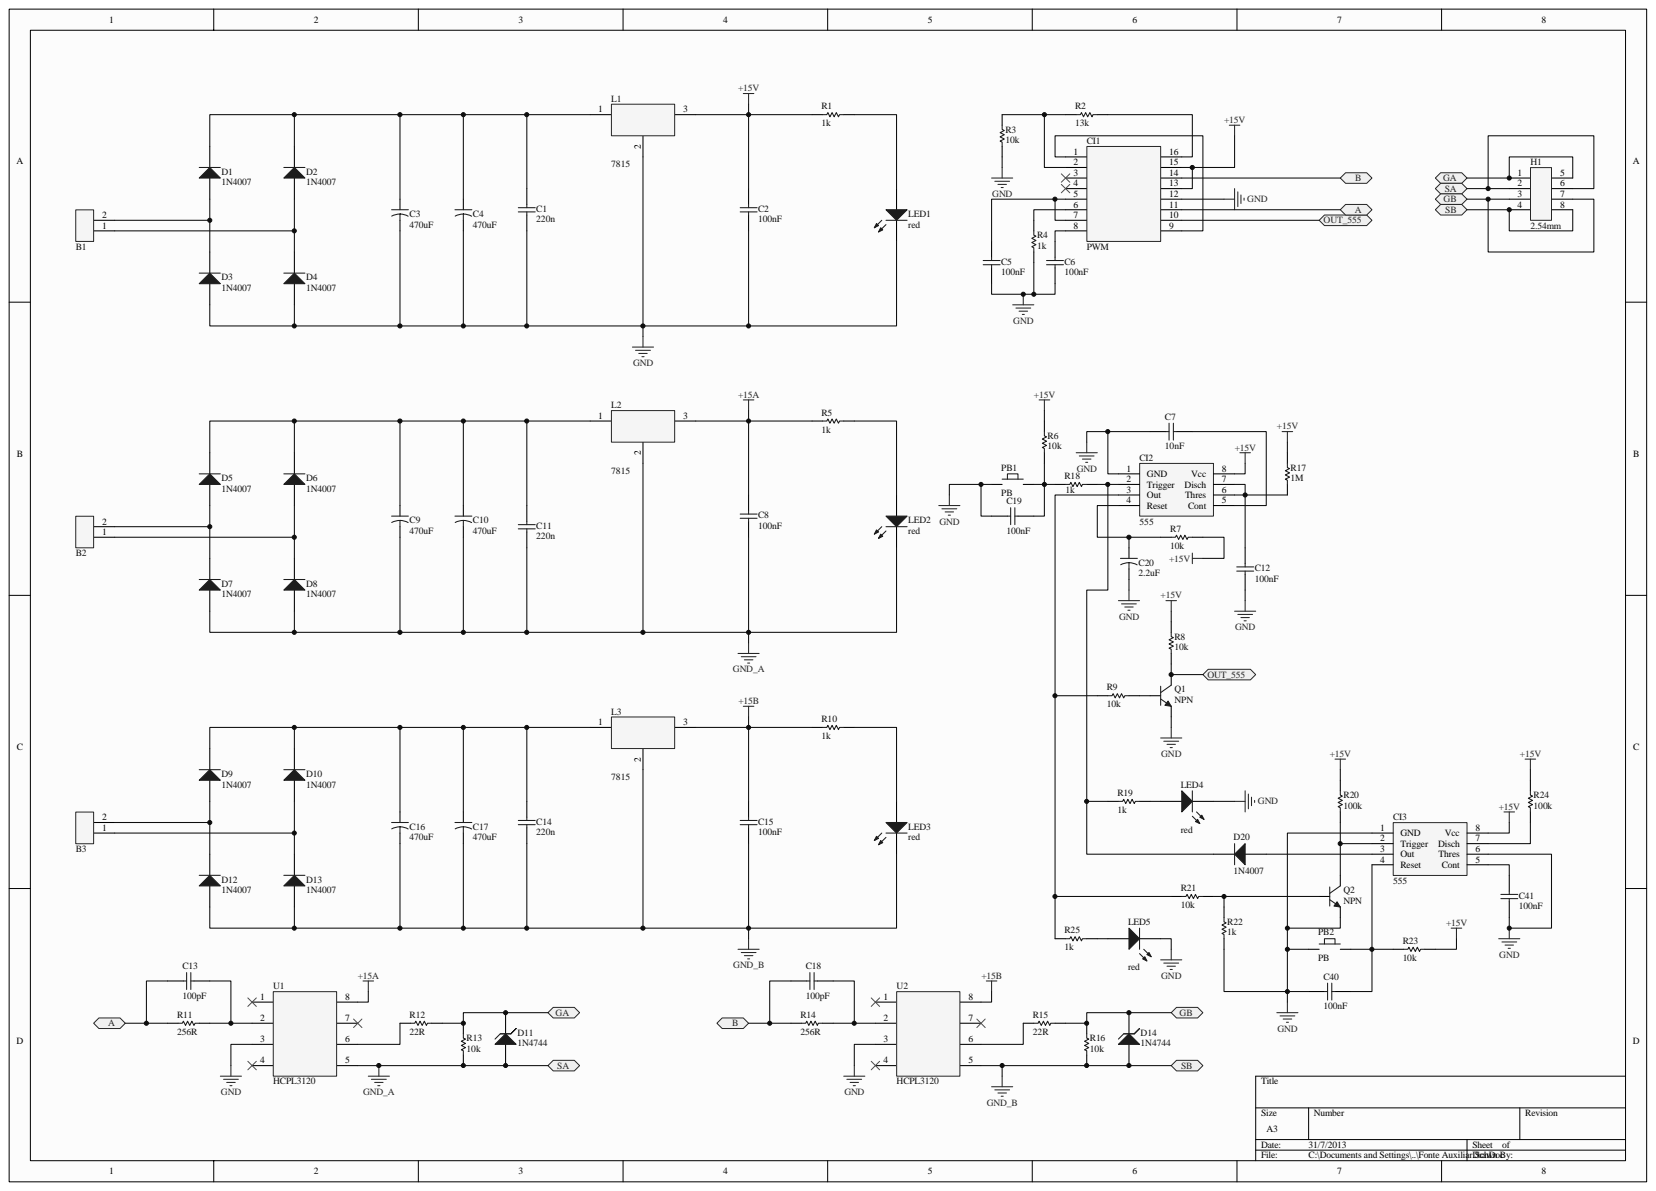
[picture p70: page 1]

Size A3 | Number | Revision

Date: 31/7/2013 | Sheet of
File: C:\Documents and Settings\..\Fonte Auxiliar.SchDoc Drawn By:
