daiooo/sistemas-de-aterramento/esquematico/iniciais/placa_potencia.pdf

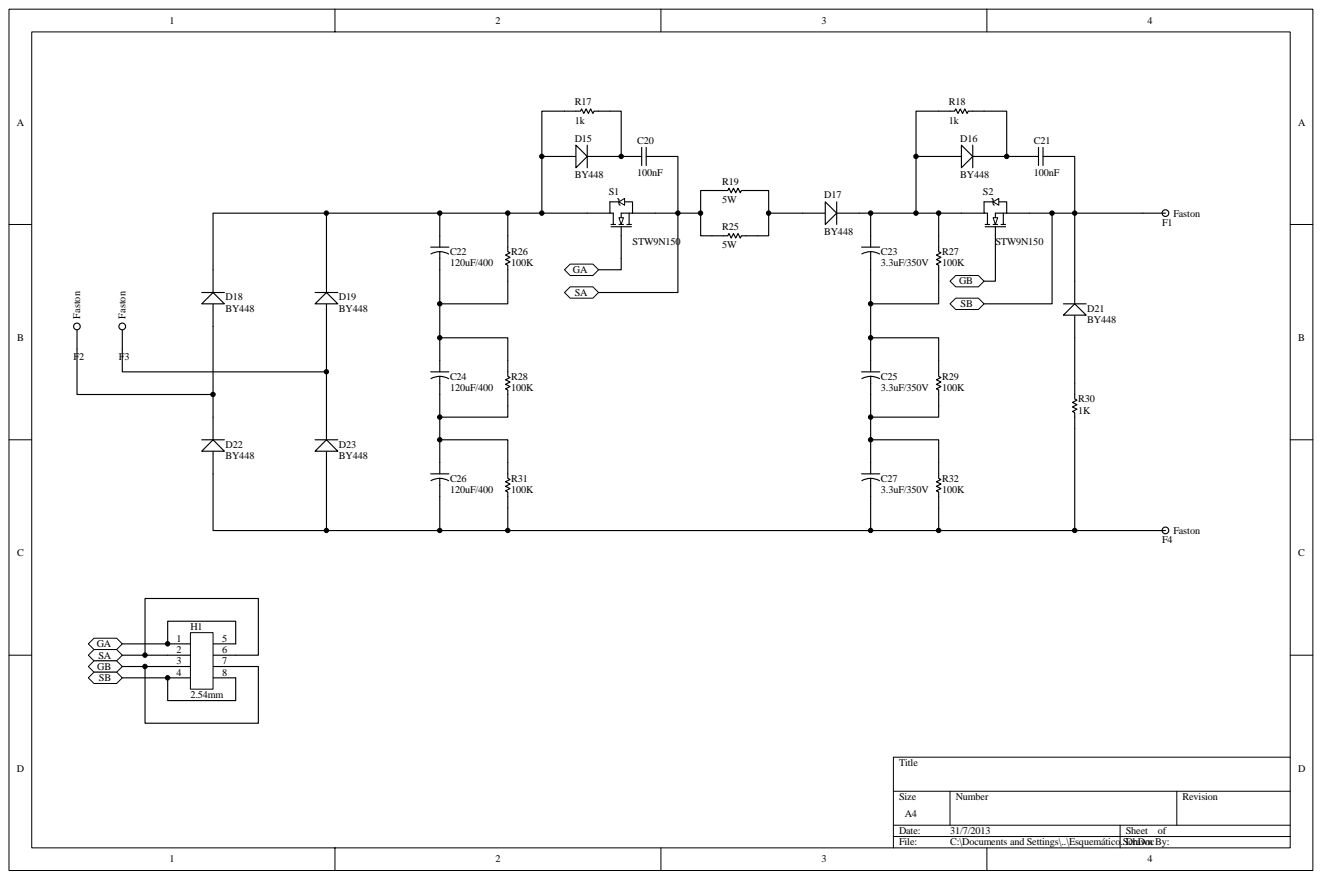
[picture p71: page 1]

Size A4 | Number | Revision

Date: 31/7/2013 | Sheet of
File: C:\Documents and Settings\..\Esquemático.SchDoc Drawn By:
