daiooo/sistemas-de-aterramento/esquematico/placa_potencia/potencia.PDF

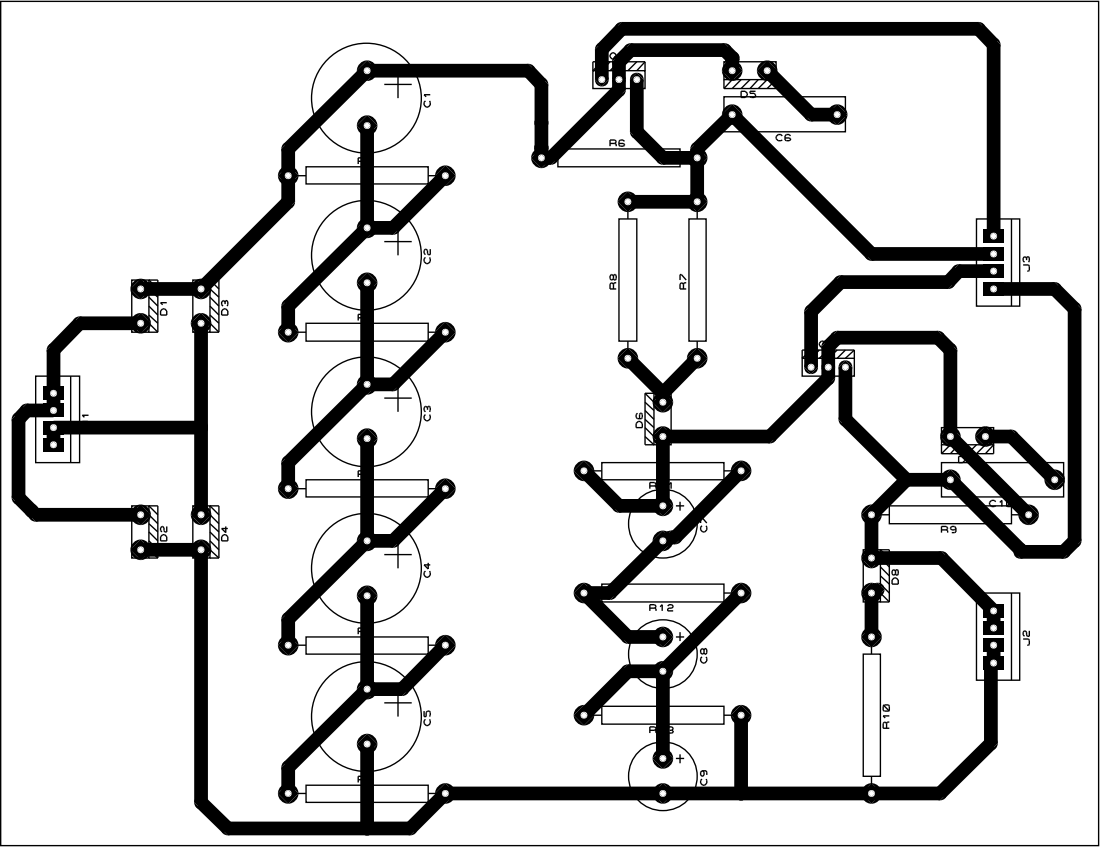
[picture p72: page 1]
