daiooo/sistemas-de-aterramento/fotos/conexoes/alimentacao.pdf

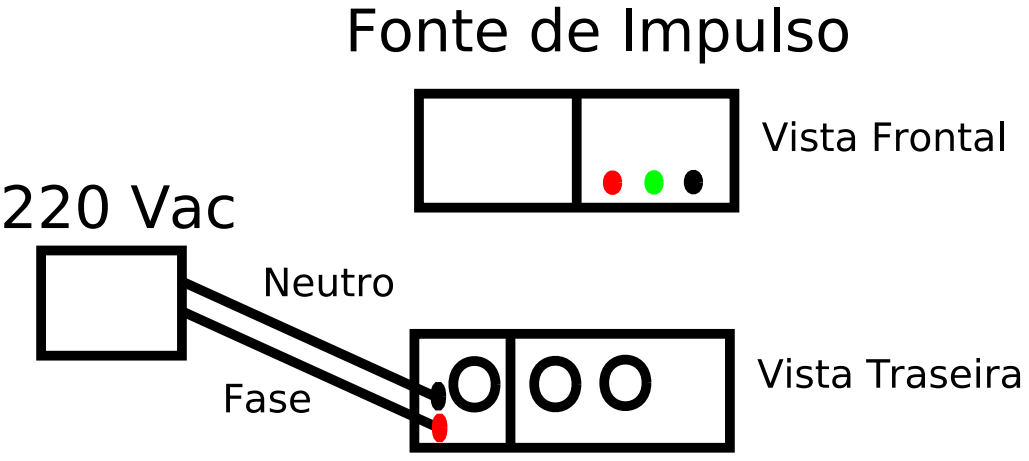
[picture p73: page 1]
