daiooo/sistemas-de-aterramento/fotos/sinal/sinal-eps-converted-to.pdf

V

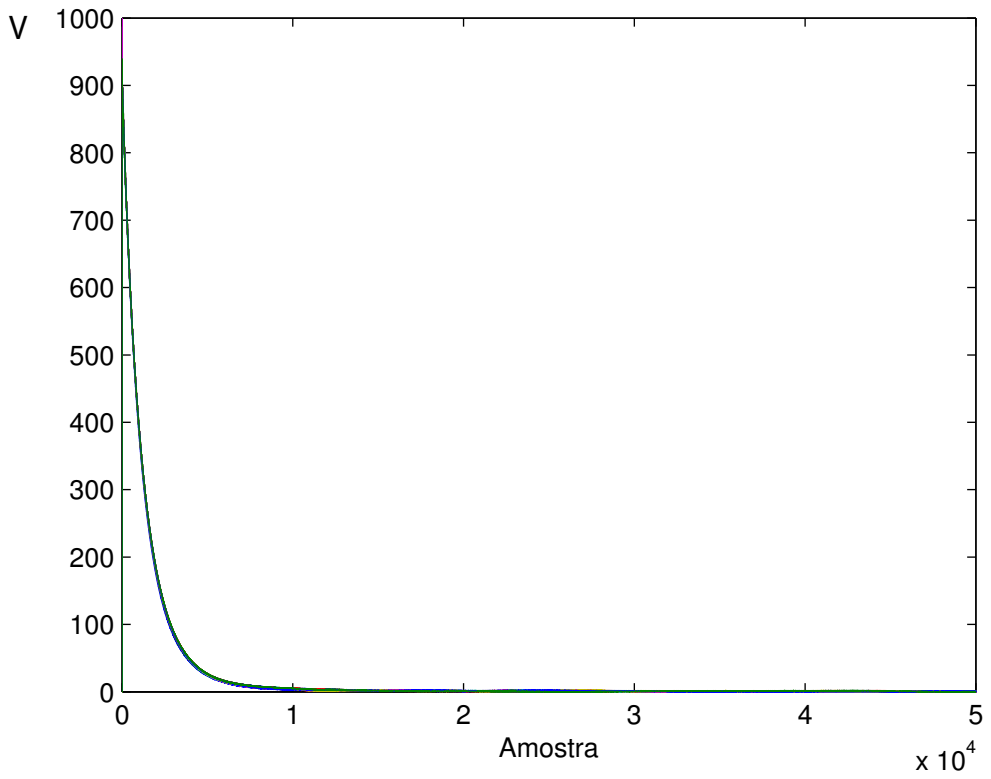
[picture p74: page 1]
