daiooo/sistemas-de-aterramento/fotos/sinal/sinal_detalhes-eps-converted-to.pdf

V

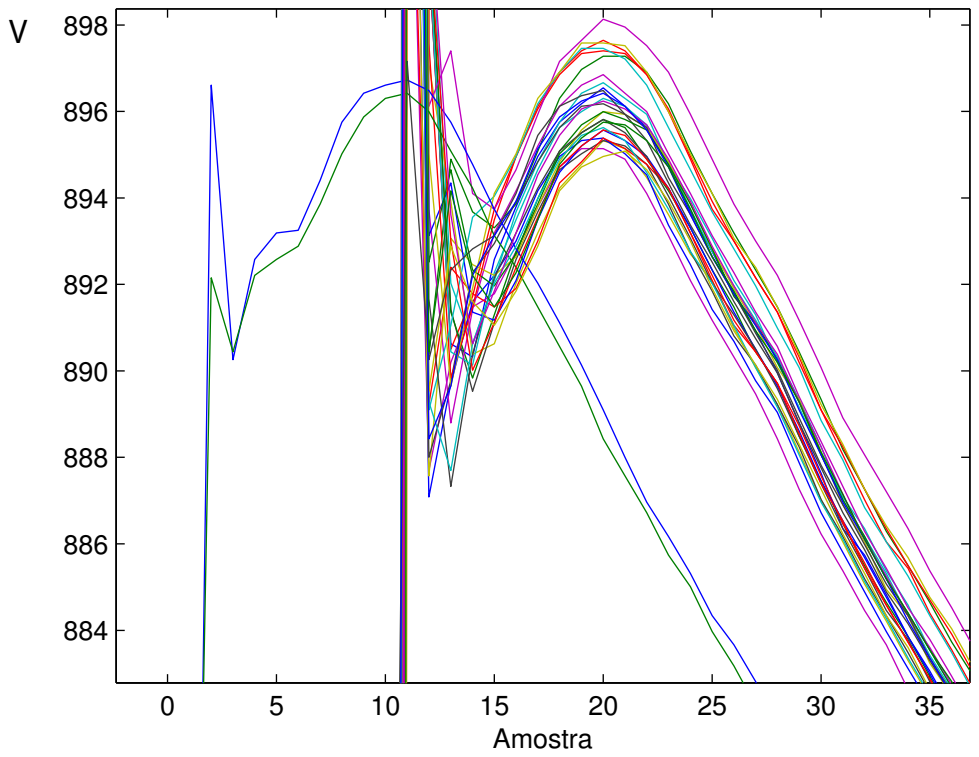
[picture p75: page 1]
Amostra
