daiooo/sistemas-de-aterramento/fotos/conexoes/hastes.pdf

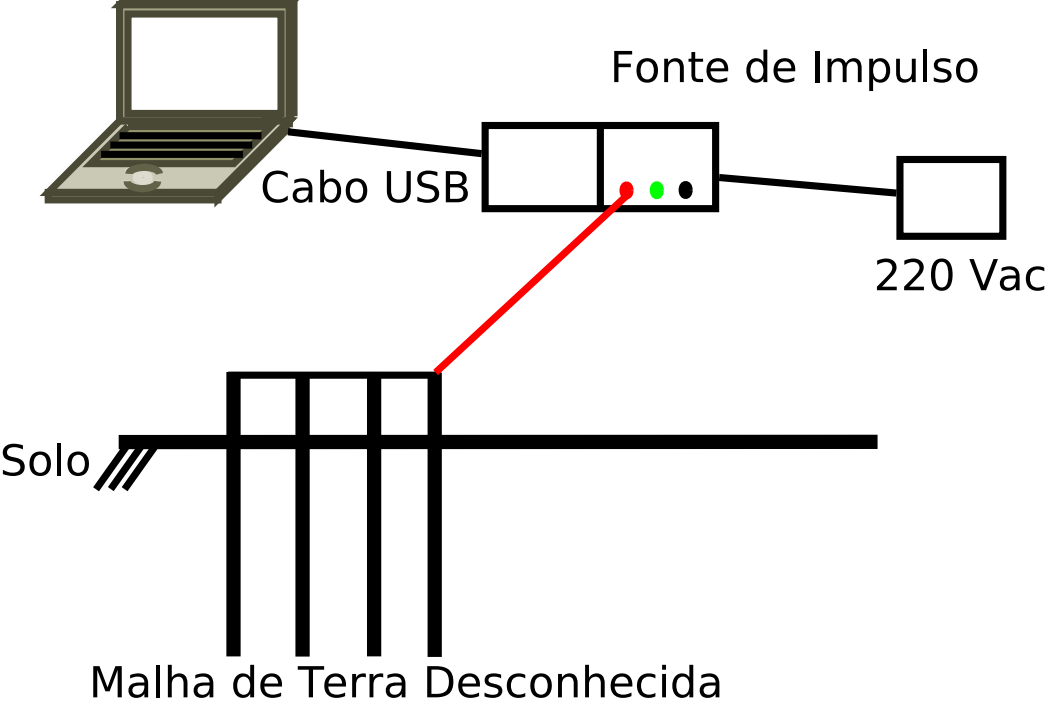
[picture p76: page 1]
