daiooo/sistemas-de-aterramento/fotos/conexoes/hastes_modo_1.pdf

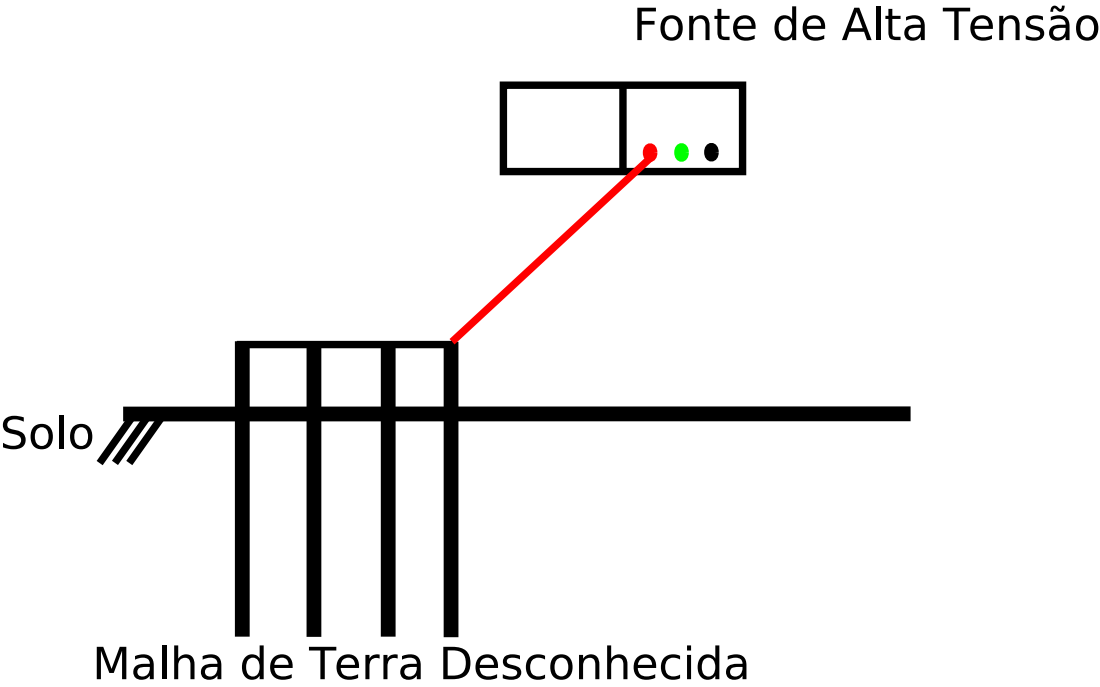
[picture p77: page 1]
