daiooo/sistemas-de-aterramento/fotos/conexoes/hastes_modo_2.pdf

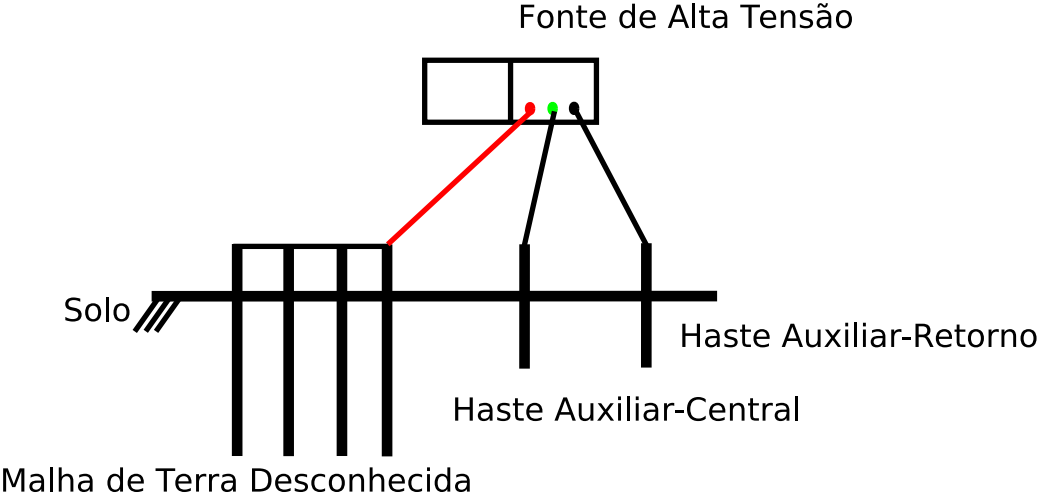
[picture p78: page 1]
