daiooo/sistemas-de-aterramento/(list of files, drawings)

Other design files:
esquematico/placa_controle/controle.pdsprj
esquematico/placa_potencia/potencia.pdsprj
