daiooo/sistemas-de-aterramento/esquematico/placa_tobias/teste.brd

## EAGLE design esquematico/placa_tobias/teste.brd (2015-12-03)

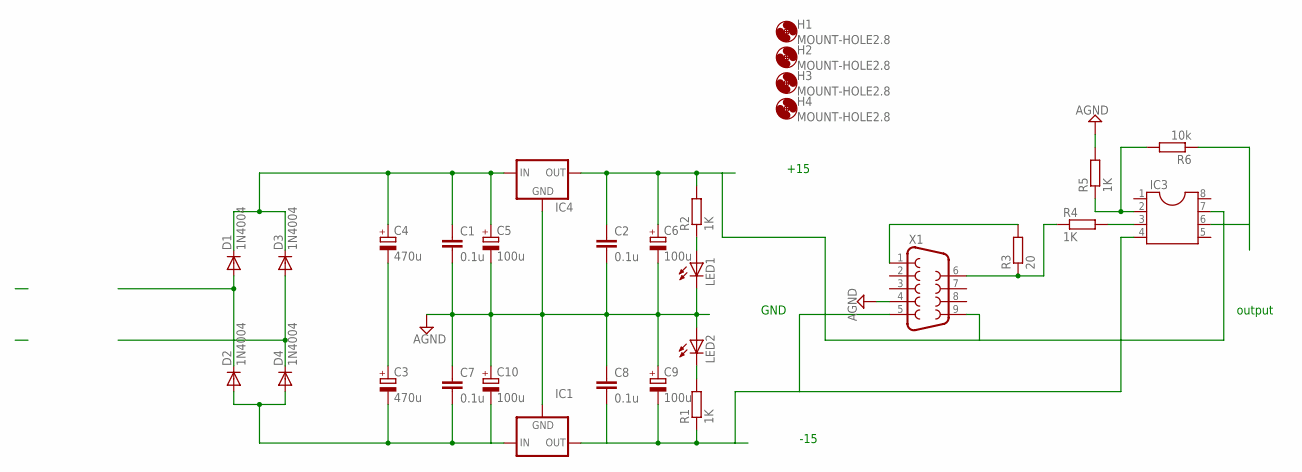
[picture p79: schematic teste.sch]

Parts:
C1, C2, C7, C8: 0.1u; C025-024X044
C3, C4: 470u; E5-10,5
C5, C6, C9, C10: 100u; E5-10,5
D1, D2, D3, D4: 1N4004; DO41-10
H1, H2, H3, H4: MOUNT-HOLE2.8; 2,8
IC1: 79XXS
IC3: DIL8; DIL08
IC4: 78XXS
LED1, LED2: LED3MM
R1, R2, R4, R5: 1K; 0207/10
R3: 20; 0207/10
R6: 10k; 0207/10
X1: F09HP

Connections:
15V+: C1.1, C4.+, C5.+, D1.C, D3.C, IC4.IN
+15V: C2.1, C6.+, IC3.7, IC4.OUT, R2.2, X1.9
-15V: C3.-, C7.2, C10.-, D2.A, D4.A, IC1.IN
AGND: C1.2, C2.2, C5.-, C6.-, C7.1, C8.1, C9.+, C10.+, IC1.GND, IC4.GND, LED1.K (C), LED2.A, R5.2, X1.4
M15: C8.2, C9.-, IC1.OUT, IC3.4, R1.1, X1.5
unnamed: C3.+, C4.-
unnamed: D3.A, D4.C
unnamed: D1.A, D2.C
unnamed: IC3.3, R4.2
unnamed: IC3.2, R5.1, R6.2
unnamed: R3.1, R4.1, X1.6
unnamed: LED2.K (C), R1.2
unnamed: R3.2, X1.1
unnamed: LED1.A, R2.1
OUT: IC3.6, R6.1

Notes on the sheet:
output
GND
+15
-15

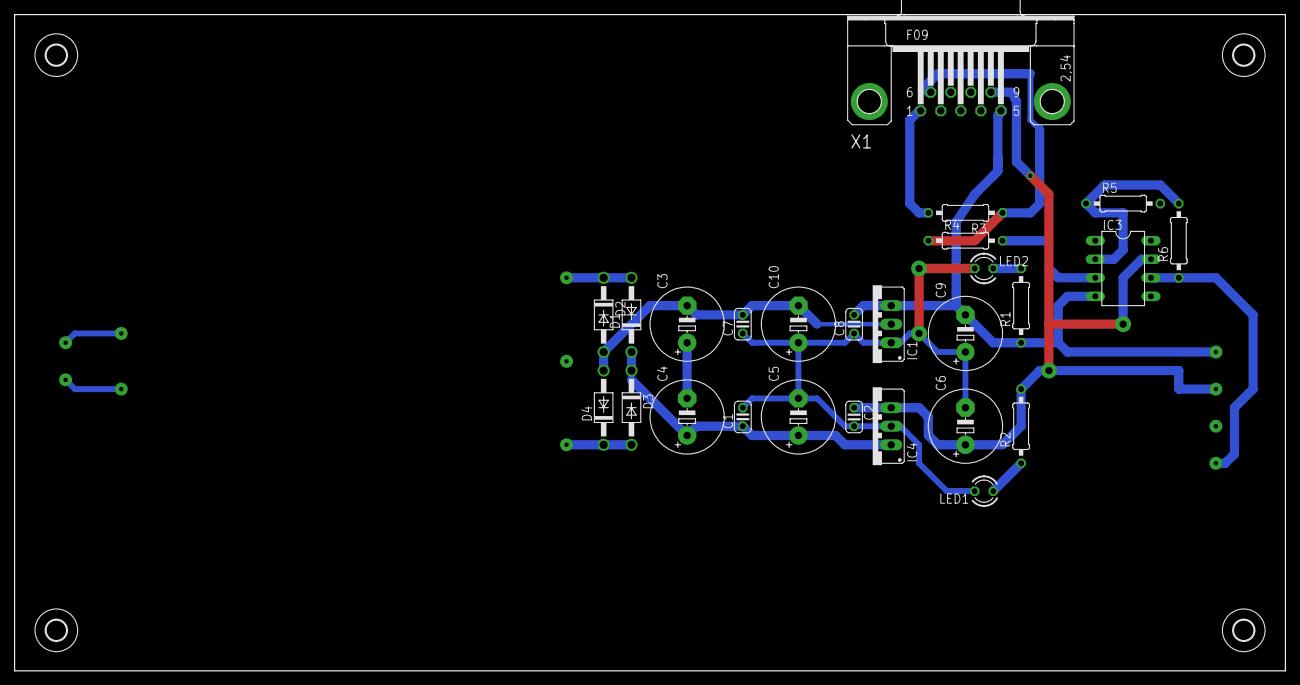
[picture p80: board teste.brd from above]

Board: 2 copper layers, 174.0 x 89.8 mm, 30 parts (0 on the bottom side), 15 nets.
