daiooo/sistemas-de-aterramento/esquematico/placa_potencia_versao_2/placa_potencia.brd

## EAGLE design esquematico/placa_potencia_versao_2/placa_potencia.brd (2015-11-26)

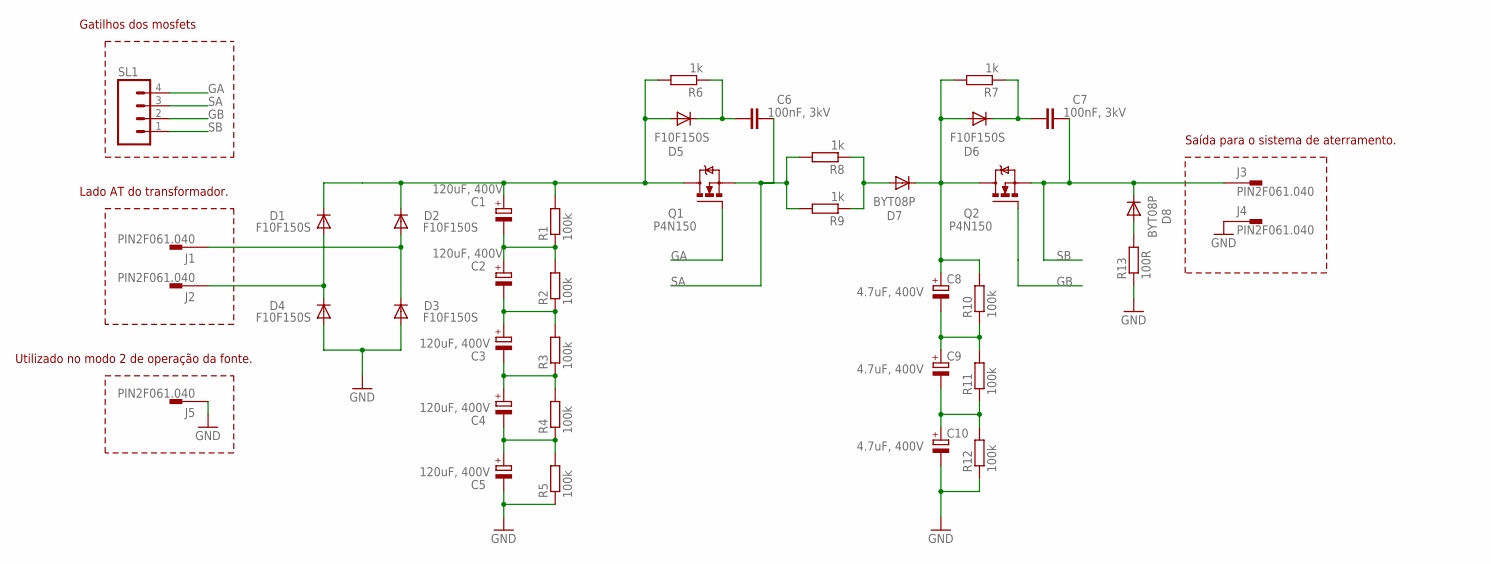
[picture p81: schematic placa_potencia.sch]

Parts:
C1, C2, C3, C4, C5: 120uF, 400V; E7,5-16
C6, C7: 100nF, 3kV; C050-035X075
C8, C9, C10: 4.7uF, 400V; E5-8,5
D1, D2, D3, D4, D5, D6: F10F150S; TO220ACS
D7, D8: BYT08P; TO220ACS
J1, J2, J3, J4, J5: PIN2F061.040; F061.040
Q1, Q2: P4N150; TO220BV
R1, R2, R3, R4, R5, R10, R11, R12: 100k; 0617/22
R6, R7, R8, R9: 1k; 0617/22
R13: 100R; 0617/22
SL1: M04; 04P

Connections:
GA: Q1.G, SL1.4
GB: Q2.G, SL1.2
GND: C5.-, C10.-, D3.A, D4.A, J4.A1, J4.A2, J5.A1, J5.A2, R5.1, R12.1, R13.1
unnamed: D1.A, D4.C, J2.A1, J2.A2
unnamed: D2.A, D3.C, J1.A1, J1.A2
unnamed: C1.-, C2.+, R1.1, R2.2
unnamed: C2.-, C3.+, R2.1, R3.2
unnamed: C3.-, C4.+, R3.1, R4.2
unnamed: C8.-, C9.+, R10.1, R11.2
unnamed: C6.1, D5.C, R6.1
unnamed: C4.-, C5.+, R4.1, R5.2
unnamed: D8.A, R13.2
unnamed: C7.1, D6.C, R7.1
unnamed: D7.A, R8.1, R9.1
unnamed: C1.+, D1.C, D2.C, D5.A, Q1.D, R1.2, R6.2
unnamed: C9.-, C10.+, R11.1, R12.2
SA: C6.2, Q1.S, R8.2, R9.2, SL1.3
SB: C7.2, D8.C, J3.A1, J3.A2, Q2.S, SL1.1
VCC1: C8.+, D6.A, D7.C, Q2.D, R7.2, R10.2

Notes on the sheet:
Saída para o sistema de aterramento.
Utilizado no modo 2 de operação da fonte.
Lado AT do transformador.
Gatilhos dos mosfets

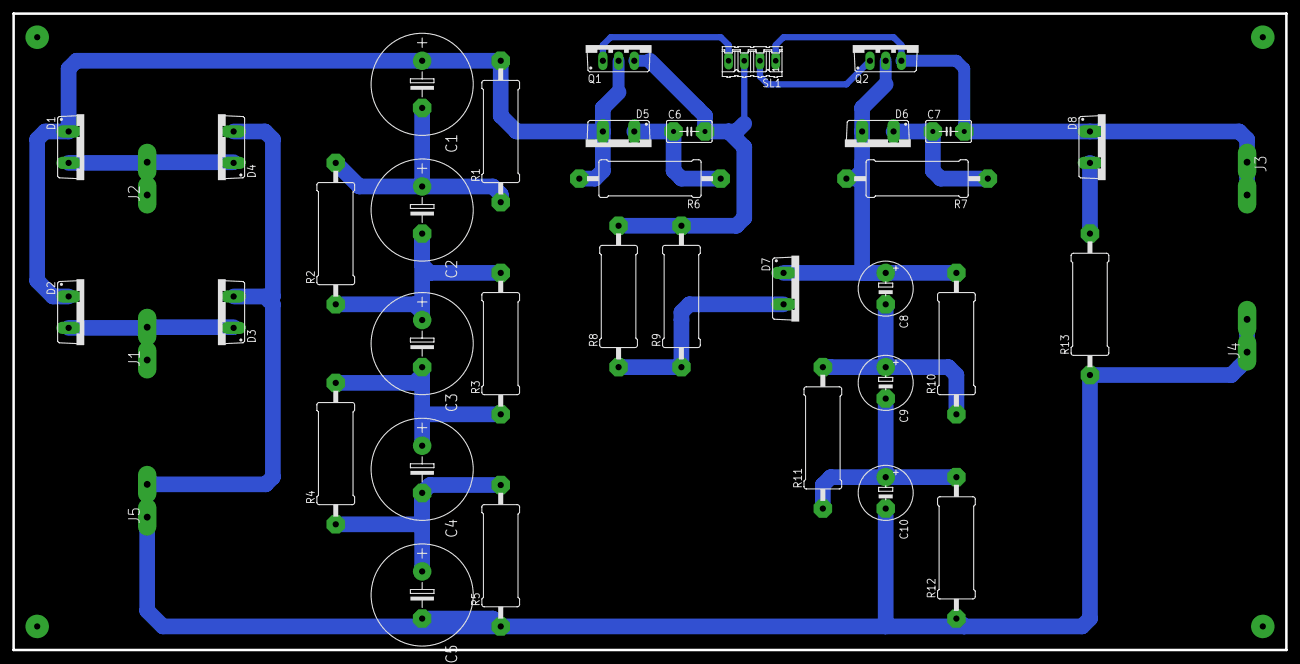
[picture p82: board placa_potencia.brd from above]

Board: 2 copper layers, 205.7 x 102.9 mm, 39 parts (0 on the bottom side), 19 nets.
