daiooo/sistemas-de-aterramento/esquematico/placa_potencia/potencia.brd

## EAGLE design esquematico/placa_potencia/potencia.brd (2015-02-09)

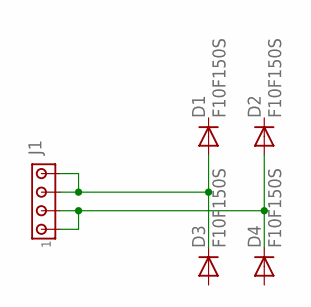
[picture p83: schematic potencia.sch]

Parts:
D1, D2, D3, D4: F10F150S; DO220S
J1: MTA04-156; 1X4MTA

Connections:
unnamed: D2.A, D4.C, J1.1, J1.2
unnamed: D1.A, D3.C, J1.3, J1.4

Board: 2 copper layers, 5 parts (0 on the bottom side), 2 nets, no tracks yet.
