daiooo/sistemas-de-aterramento/(commit log)

2015-02-09 commit inicial, repositorio antigo: https://github.com/felipeband/agilent.git
    [controle.pdsprj, l.obj, p16.production.obj, potencia.brd, potencia.pdsprj, potencia.sch]
2015-02-24 continuando o principio de funcionamento. É necessário modificar as fotos do software
2015-02-24 inserção do esquematico de ligação da alimentação. encontrado pequenas referencias a fonte de forma errada
2015-02-24 para amanhã: terminar o principio de funcionamento
2015-02-26 correções propostas feitas, melhorias na identificação do exemplo faltando agora os classificadores na principio de funcionamento.
2015-03-03 finalizando o processo de treinamento. inclusao de tabelas melhores. relatorio etapa 10 incluido no projeto
2015-03-04 principio de funcionamento terminado. enviar para o tobias
2015-03-04 link para o copy
2015-03-05 nao é necessário principio de funcionamento
2015-03-10 versão quyase final para o Tobias
2015-06-18 atualização dos gerbe
    [controle.pdsprj, potencia.pdsprj]
2015-06-18 correções nas trilhas e pads
    [potencia.pdsprj]
2015-06-18 atualizando com os esquematicos iniciais
    [potencia.pdsprj]
2015-06-23 o pyvisa foi atualizado para versao 1.8 que é incompativel com a versao do software da fonte. Só funciona com a versao 1.4. Sem tempos para modificacoes
2015-11-26 placa de potencia versão 2
    [placa_potencia.brd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]
2015-12-03 placa tobias
    [borda.gko, bottom.gbl, placa_TC.GBL, placa_TC.GBO, placa_TC.GBS, placa_TC.GTL, placa_TC.GTO, placa_TC.GTP]
